findasifrahman/mt76--/mt7628v1.kicad_pcb

## KiCad design mt7628v1.kicad_pcb (2025-05-23)

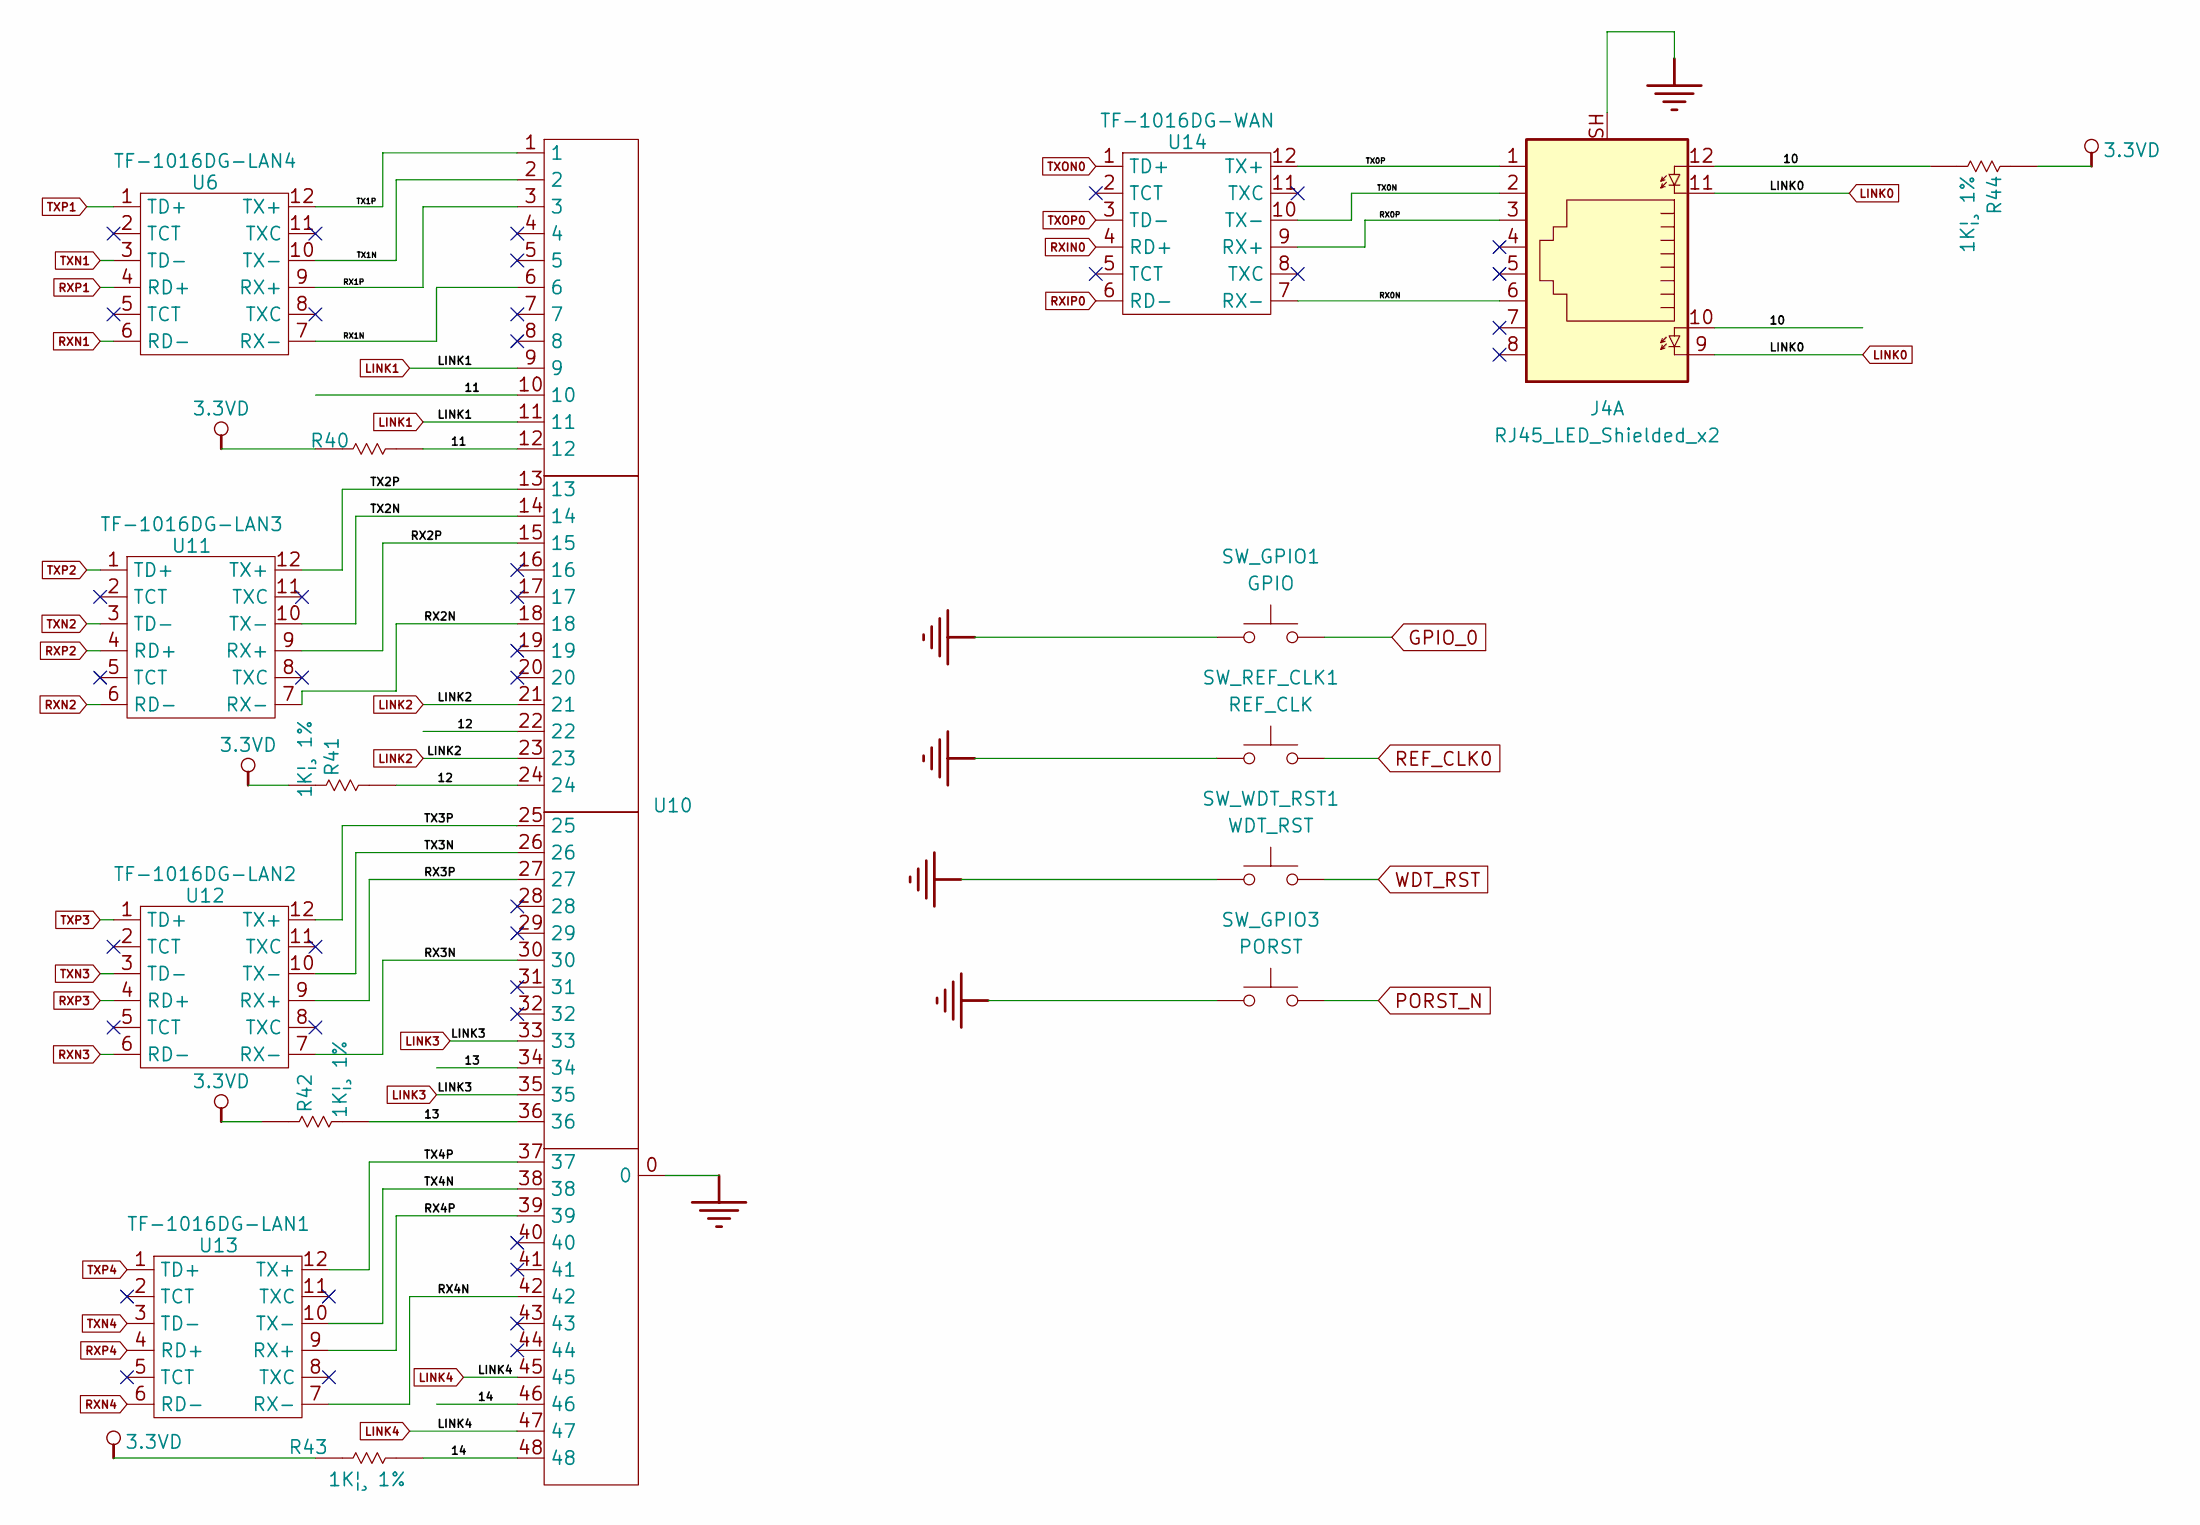
[picture p1: schematic ethernet.kicad_sch]

Parts:
J4: RJ45_LED_Shielded_x2; RJ45-TH_DS1128-09-S8B8X; LCSC C86578
R40, R41, R42, R43, R44: 1k/1%; R_0402_1005Metric; LCSC C11702
SW_GPIO1: GPIO; SW-SMD_L3.9-W2.9-LS4.8-EH-A; LCSC C9900006416
SW_GPIO3: PORST; SW-SMD_L3.9-W2.9-LS4.8-EH-A; LCSC C9900006416
SW_REF_CLK1: REF_CLK; SW-SMD_L3.9-W2.9-LS4.8-EH-A; LCSC C9900006416
SW_WDT_RST1: WDT_RST; SW-SMD_L3.9-W2.9-LS4.8-EH-A; LCSC C9900006416
U6: TF-1016DG-LAN4; DIP-12_L12.8-W7.3-P2.00-LS5.0-BL; LCSC C408871
U10: RJ45-TH_B-1-4; LCSC C138390
U11: TF-1016DG-LAN3; DIP-12_L12.8-W7.3-P2.00-LS5.0-BL; LCSC C408871
U12: TF-1016DG-LAN2; DIP-12_L12.8-W7.3-P2.00-LS5.0-BL; LCSC C408871
U13: TF-1016DG-LAN1; DIP-12_L12.8-W7.3-P2.00-LS5.0-BL; LCSC C408871
U14: TF-1016DG-WAN; DIP-12_L12.8-W7.3-P2.00-LS5.0-BL; LCSC C408871

Connections:
3.3VD: R40.2, R41.2, R42.2, R43.2, R44.2; also elsewhere on the board
/ethernet/10: J4.10, J4.12, R44.1
/ethernet/11: R40.1, U10.10, U10.12
/ethernet/12: R41.1, U10.22, U10.24
/ethernet/13: R42.1, U10.34, U10.36
/ethernet/14: R43.1, U10.46, U10.48
/ethernet/RX0N: J4.6, U14.7 (RX-)
/ethernet/RX0P: J4.3, U14.9 (RX+)
/ethernet/RX1N: U6.7 (RX-), U10.6
/ethernet/RX1P: U6.9 (RX+), U10.3
/ethernet/RX2N: U10.18, U11.7 (RX-)
/ethernet/RX2P: U10.15, U11.9 (RX+)
/ethernet/RX3N: U10.30, U12.7 (RX-)
/ethernet/RX3P: U10.27, U12.9 (RX+)
/ethernet/RX4N: U10.42, U13.7 (RX-)
/ethernet/RX4P: U10.39, U13.9 (RX+)
/ethernet/TX0N: J4.2, U14.10 (TX-)
/ethernet/TX0P: J4.1, U14.12 (TX+)
/ethernet/TX1N: U6.10 (TX-), U10.2
/ethernet/TX1P: U6.12 (TX+), U10.1
/ethernet/TX2N: U10.14, U11.10 (TX-)
/ethernet/TX2P: U10.13, U11.12 (TX+)
/ethernet/TX3N: U10.26, U12.10 (TX-)
/ethernet/TX3P: U10.25, U12.12 (TX+)
/ethernet/TX4N: U10.38, U13.10 (TX-)
/ethernet/TX4P: U10.37, U13.12 (TX+)
CPURST_N: SW_GPIO3.2; also elsewhere on the board
GND: J4.SH, SW_GPIO1.1, SW_GPIO3.1, SW_REF_CLK1.1, SW_WDT_RST1.1, U10.0; also elsewhere on the board
GPIO_0: SW_GPIO1.2; also elsewhere on the board
LINK0: J4.9, J4.11; also elsewhere on the board
LINK1: U10.9, U10.11; also elsewhere on the board
LINK2: U10.21, U10.23; also elsewhere on the board
LINK3: U10.33, U10.35; also elsewhere on the board
LINK4: U10.45, U10.47; also elsewhere on the board
REF_CLK0: SW_REF_CLK1.2; also elsewhere on the board
RXIN0: U14.4 (RD+); also elsewhere on the board
RXIP0: U14.6 (RD-); also elsewhere on the board
RXN1: U6.6 (RD-); also elsewhere on the board
RXN2: U11.6 (RD-); also elsewhere on the board
RXN3: U12.6 (RD-); also elsewhere on the board
RXN4: U13.6 (RD-); also elsewhere on the board
RXP1: U6.4 (RD+); also elsewhere on the board
RXP2: U11.4 (RD+); also elsewhere on the board
RXP3: U12.4 (RD+); also elsewhere on the board
RXP4: U13.4 (RD+); also elsewhere on the board
TXN1: U6.3 (TD-); also elsewhere on the board
TXN2: U11.3 (TD-); also elsewhere on the board
TXN3: U12.3 (TD-); also elsewhere on the board
TXN4: U13.3 (TD-); also elsewhere on the board
TXON0: U14.1 (TD+); also elsewhere on the board
TXOP0: U14.3 (TD-); also elsewhere on the board
TXP1: U6.1 (TD+); also elsewhere on the board
TXP2: U11.1 (TD+); also elsewhere on the board
TXP3: U12.1 (TD+); also elsewhere on the board
TXP4: U13.1 (TD+); also elsewhere on the board
WDT_RST: SW_WDT_RST1.2; also elsewhere on the board

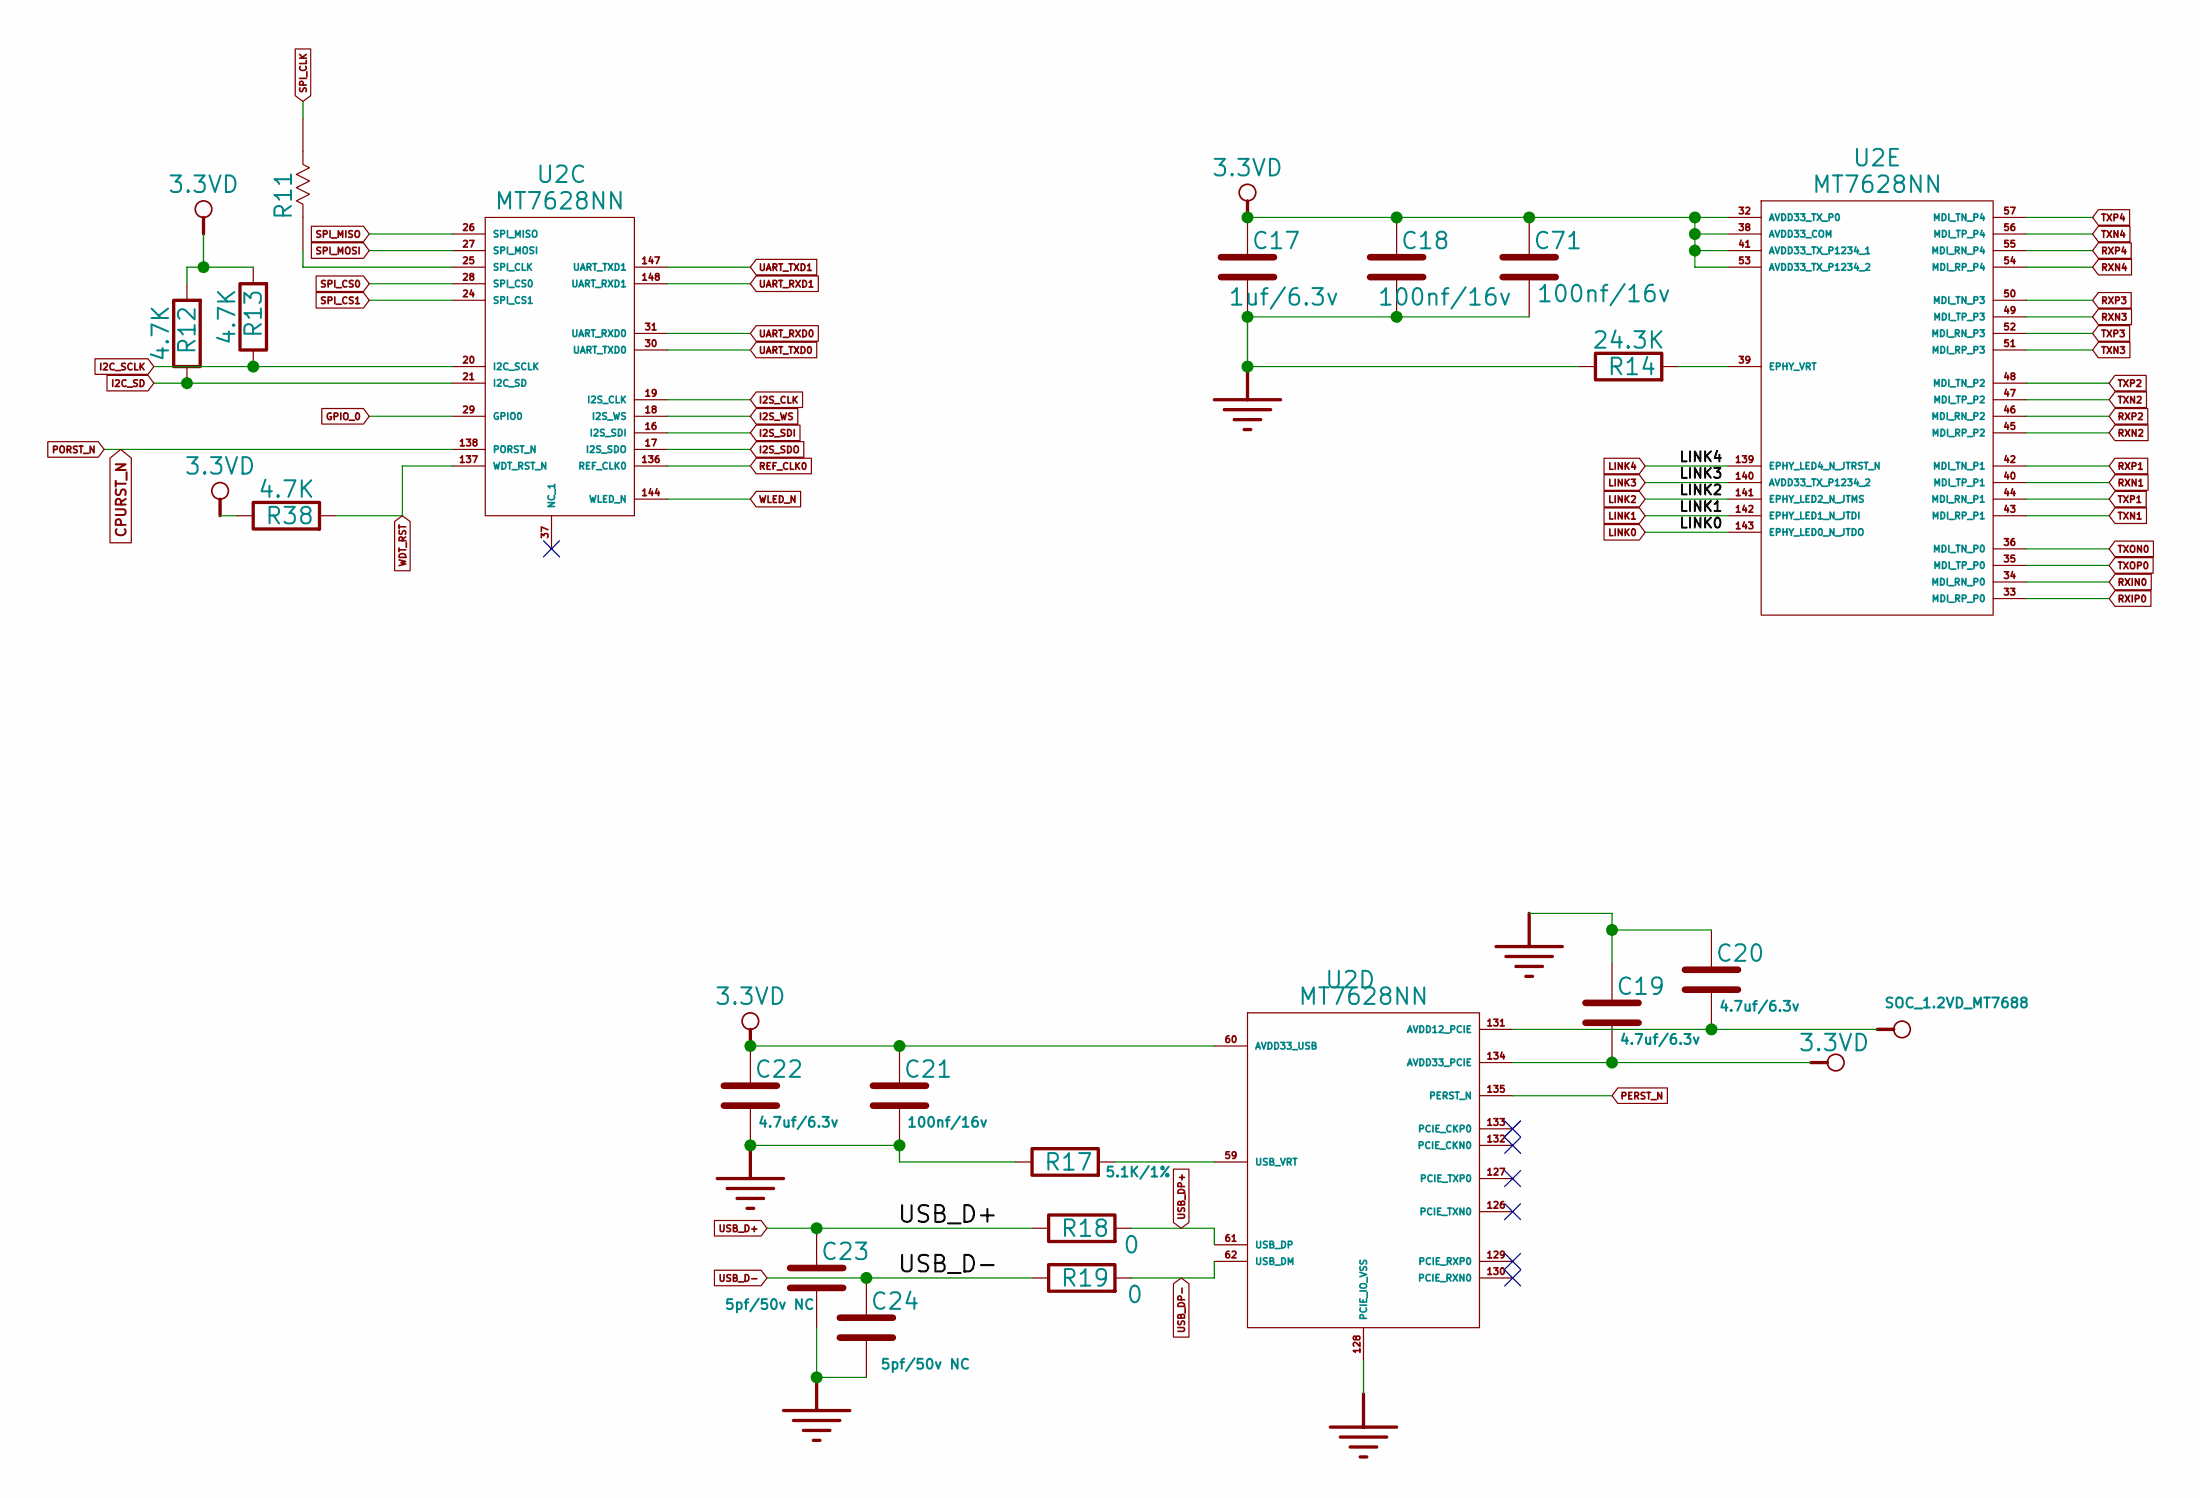
[picture p2: schematic Pheripheral.kicad_sch]

Parts:
C17: 1uf/6.3v; C_0402_1005Metric; LCSC C15684
C18, C21, C71: 100nf/16v; C_0402_1005Metric; LCSC C1525
C19, C20, C22: 4.7uf/6.3v; C_0603_1608Metric; LCSC C8032
C23, C24: 5pf/50v NC; C_0402_1005Metric; LCSC C1573
R11: 22; R_0402_1005Metric; LCSC C25092
R12, R13, R38: 4.7K; R_0402_1005Metric; LCSC C25900
R14: 24.3K; R_0402_1005Metric; LCSC C102920
R17: 5.1K/1%; C_0402_1005Metric; LCSC C25905
R18, R19: 0; R_0402_1005Metric; LCSC C17168
U2: MT7628NN; MT7628_footprint; LCSC C2762437

Connections:
3.3VD: C17.1, C18.1, C19.2, C21.1, C22.1, C71.1, R12.2, R13.2, R38.1, U2.32 (AVDD33_TX_P0), U2.38 (AVDD33_COM), U2.41 (AVDD33_TX_P1234_1), U2.53 (AVDD33_TX_P1234_2), U2.60 (AVDD33_USB), U2.134 (AVDD33_PCIE); also elsewhere on the board
CPURST_N: U2.138 (PORST_N); also elsewhere on the board
GND: C17.2, C18.2, C19.1, C20.1, C21.2, C22.2, C23.2, C24.2, C71.2, R14.1, R17.1, U2.128 (PCIE_IO_VSS); also elsewhere on the board
GPIO_0: U2.29 (GPIO0); also elsewhere on the board
I2C_SCLK: R13.1, U2.20 (I2C_SCLK); also elsewhere on the board
I2C_SD: R12.1, U2.21 (I2C_SD); also elsewhere on the board
I2S_CLK: U2.19 (I2S_CLK); also elsewhere on the board
I2S_SDI: U2.16 (I2S_SDI); also elsewhere on the board
I2S_SDO: U2.17 (I2S_SDO); also elsewhere on the board
I2S_WS: U2.18 (I2S_WS); also elsewhere on the board
LINK0: U2.143 (EPHY_LED0_N_JTDO); also elsewhere on the board
LINK1: U2.142 (EPHY_LED1_N_JTDI); also elsewhere on the board
LINK2: U2.141 (EPHY_LED2_N_JTMS); also elsewhere on the board
LINK3: U2.140 (AVDD33_TX_P1234_2); also elsewhere on the board
LINK4: U2.139 (EPHY_LED4_N_JTRST_N); also elsewhere on the board
unnamed: R11.2, U2.25 (SPI_CLK)
unnamed: R17.2, U2.59 (USB_VRT)
unnamed: R14.2, U2.39 (EPHY_VRT)
PERST_N: U2.135 (PERST_N); also elsewhere on the board
REF_CLK0: U2.136 (REF_CLK0); also elsewhere on the board
RXIN0: U2.34 (MDI_RN_P0); also elsewhere on the board
RXIP0: U2.33 (MDI_RP_P0); also elsewhere on the board
RXN1: U2.40 (MDI_TP_P1); also elsewhere on the board
RXN2: U2.45 (MDI_RP_P2); also elsewhere on the board
RXN3: U2.49 (MDI_TP_P3); also elsewhere on the board
RXN4: U2.54 (MDI_RP_P4); also elsewhere on the board
RXP1: U2.42 (MDI_TN_P1); also elsewhere on the board
RXP2: U2.46 (MDI_RN_P2); also elsewhere on the board
RXP3: U2.50 (MDI_TN_P3); also elsewhere on the board
RXP4: U2.55 (MDI_RN_P4); also elsewhere on the board
SOC_1.2VD_MT7688: C20.2, U2.131 (AVDD12_PCIE)
SPI_CLK: R11.1; also elsewhere on the board
SPI_CS0: U2.28 (SPI_CS0); also elsewhere on the board
SPI_CS1: U2.24 (SPI_CS1); also elsewhere on the board
SPI_MISO: U2.26 (SPI_MISO); also elsewhere on the board
SPI_MOSI: U2.27 (SPI_MOSI); also elsewhere on the board
TXN1: U2.43 (MDI_RP_P1); also elsewhere on the board
TXN2: U2.47 (MDI_TP_P2); also elsewhere on the board
TXN3: U2.51 (MDI_RP_P3); also elsewhere on the board
TXN4: U2.56 (MDI_TP_P4); also elsewhere on the board
TXON0: U2.36 (MDI_TN_P0); also elsewhere on the board
TXOP0: U2.35 (MDI_TP_P0); also elsewhere on the board
TXP1: U2.44 (MDI_RN_P1); also elsewhere on the board
TXP2: U2.48 (MDI_TN_P2); also elsewhere on the board
TXP3: U2.52 (MDI_RN_P3); also elsewhere on the board
TXP4: U2.57 (MDI_TN_P4); also elsewhere on the board
UART_RXD0: U2.31 (UART_RXD0); also elsewhere on the board
UART_RXD1: U2.148 (UART_RXD1); also elsewhere on the board
UART_TXD0: U2.30 (UART_TXD0); also elsewhere on the board
UART_TXD1: U2.147 (UART_TXD1); also elsewhere on the board
USB_D+: C23.1, R18.1; also elsewhere on the board
USB_D-: C24.1, R19.1; also elsewhere on the board
USB_DP+: R18.2, U2.61 (USB_DP)
USB_DP-: R19.2, U2.62 (USB_DM)
WDT_RST: R38.2, U2.137 (WDT_RST_N); also elsewhere on the board
WLED_N: U2.144 (WLED_N); also elsewhere on the board

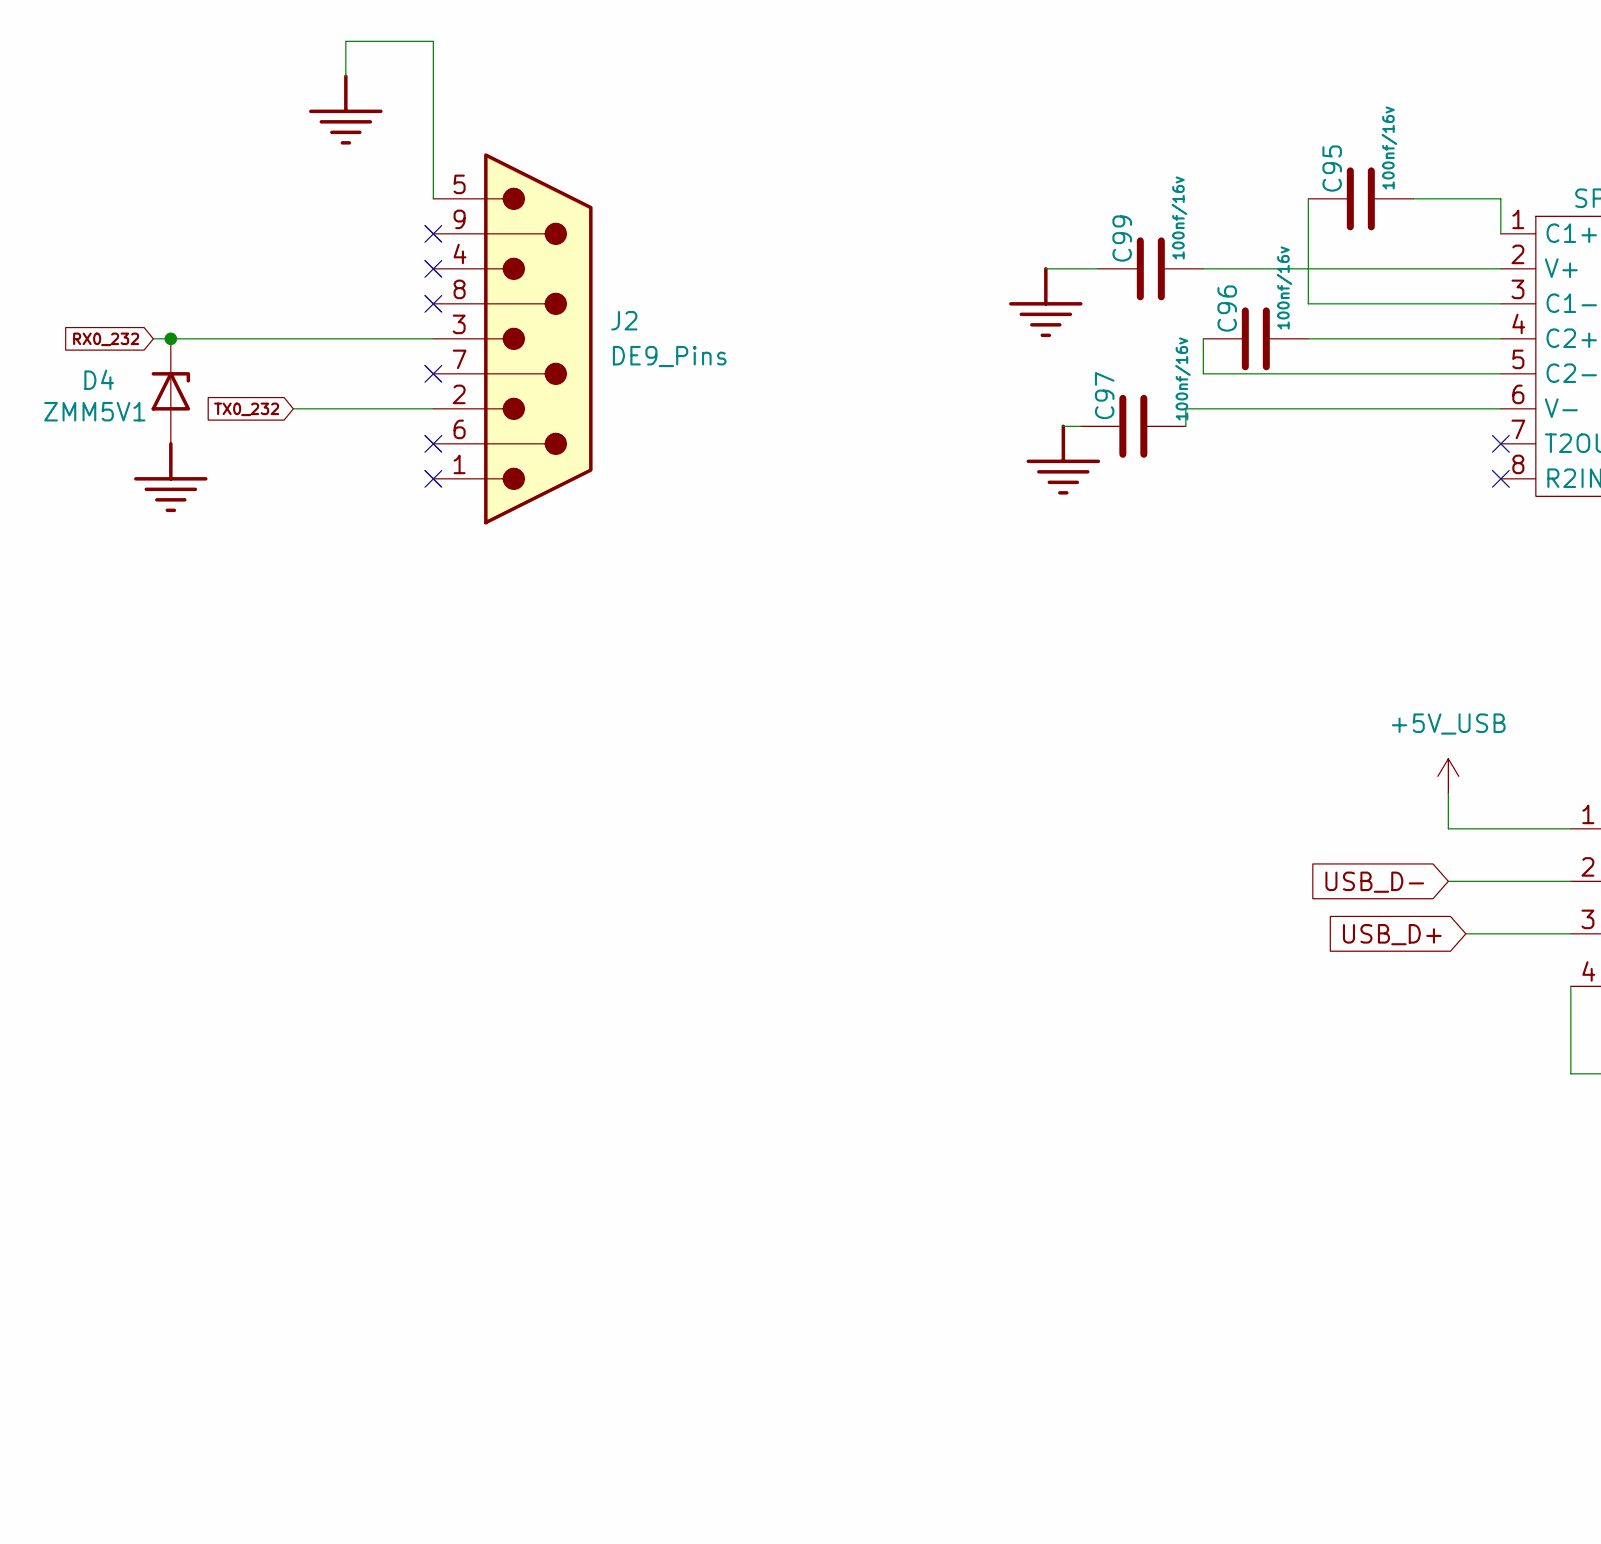
[picture p3: schematic serial.kicad_sch, part in row 1, column 1]

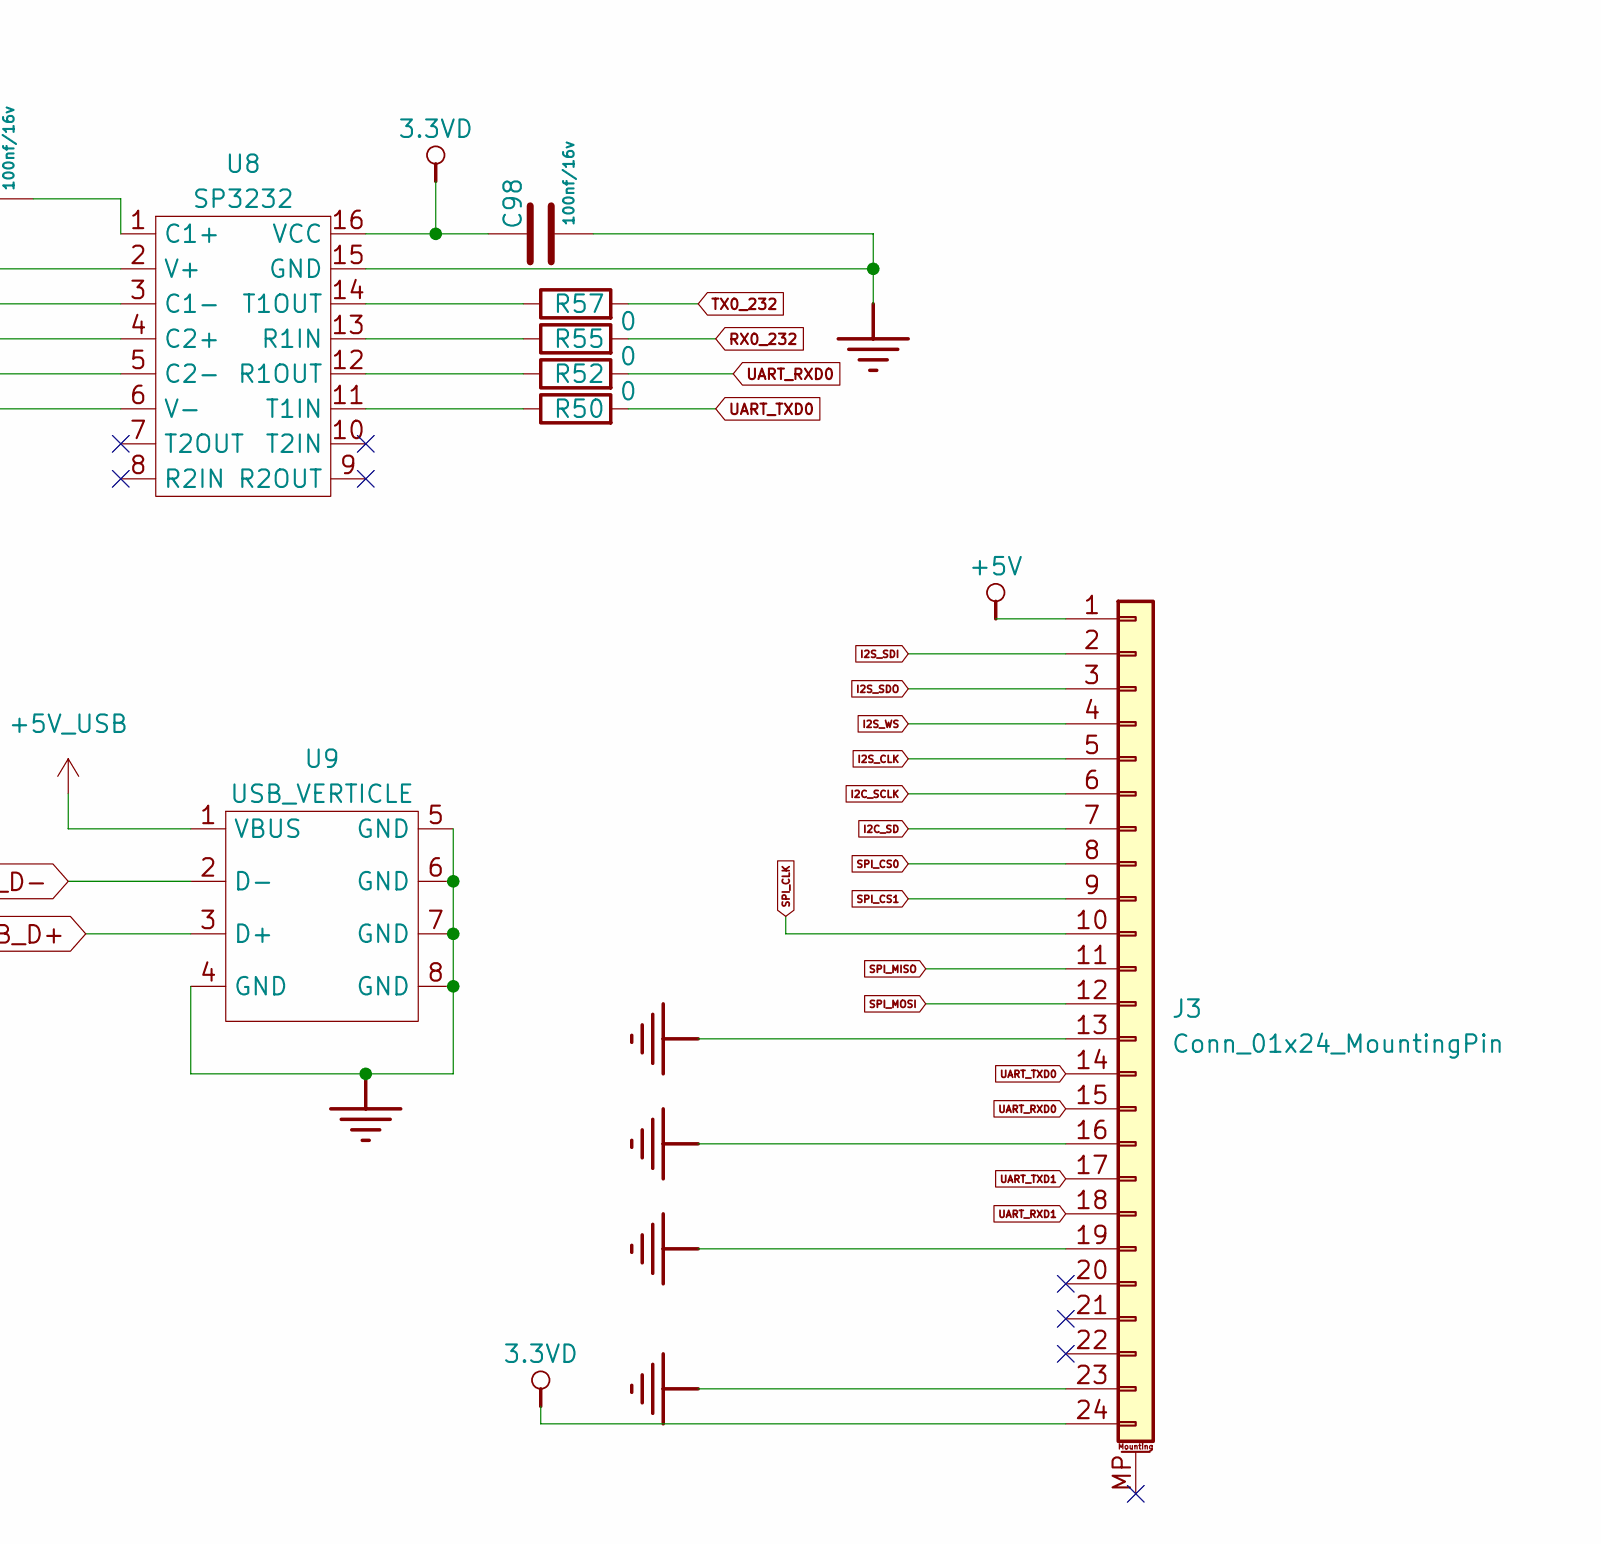
[picture p4: schematic serial.kicad_sch, part in row 1, column 2]

Parts:
C95, C96, C97, C98, C99: 100nf/16v; C_0402_1005Metric; LCSC C1525
D4: ZMM5V1; LL-34_L3.5-W1.5-RD; LCSC C707194
J2: DE9_Pins; HDR-TH_HL-DP9HB180F; LCSC C9900001049
J3: Conn_01x24_MountingPin; HDR-TH_24P-P2.54-V-M-R2-C12-S2.54; LCSC C358700
R50, R52, R55, R57: 0; R_0402_1005Metric; LCSC C17168
U8: SP3232; SOIC-16_L9.9-W3.9-P1.27-LS6.0-BL; LCSC C9378
U9: USB_VERTICLE; USB-A-TH_USB-226-BRW; LCSC C720524

Connections:
3.3VD: C98.1, J3.24, U8.16 (VCC); also elsewhere on the board
+5V: J3.1; also elsewhere on the board
+5V_USB: U9.1 (VBUS)
GND: C97.1, C98.2, C99.1, D4.2 (A), J2.5, J3.13, J3.16, J3.19, J3.23, U8.15 (GND), U9.4 (GND), U9.5 (GND), U9.6 (GND), U9.7 (GND), U9.8 (GND); also elsewhere on the board
I2C_SCLK: J3.6; also elsewhere on the board
I2C_SD: J3.7; also elsewhere on the board
I2S_CLK: J3.5; also elsewhere on the board
I2S_SDI: J3.2; also elsewhere on the board
I2S_SDO: J3.3; also elsewhere on the board
I2S_WS: J3.4; also elsewhere on the board
unnamed: C95.2, U8.1 (C1+)
unnamed: C95.1, U8.3 (C1-)
unnamed: C96.2, U8.4 (C2+)
unnamed: C96.1, U8.5 (C2-)
unnamed: R55.1, U8.13 (R1IN)
unnamed: R52.1, U8.12 (R1OUT)
unnamed: R50.1, U8.11 (T1IN)
unnamed: R57.1, U8.14 (T1OUT)
unnamed: C99.2, U8.2 (V+)
unnamed: C97.2, U8.6 (V-)
RX0_232: D4.1 (K), J2.3, R55.2
SPI_CLK: J3.10; also elsewhere on the board
SPI_CS0: J3.8; also elsewhere on the board
SPI_CS1: J3.9; also elsewhere on the board
SPI_MISO: J3.11; also elsewhere on the board
SPI_MOSI: J3.12; also elsewhere on the board
TX0_232: J2.2, R57.2
UART_RXD0: J3.15, R52.2; also elsewhere on the board
UART_RXD1: J3.18; also elsewhere on the board
UART_TXD0: J3.14, R50.2; also elsewhere on the board
UART_TXD1: J3.17; also elsewhere on the board
USB_D+: U9.3 (D+); also elsewhere on the board
USB_D-: U9.2 (D-); also elsewhere on the board

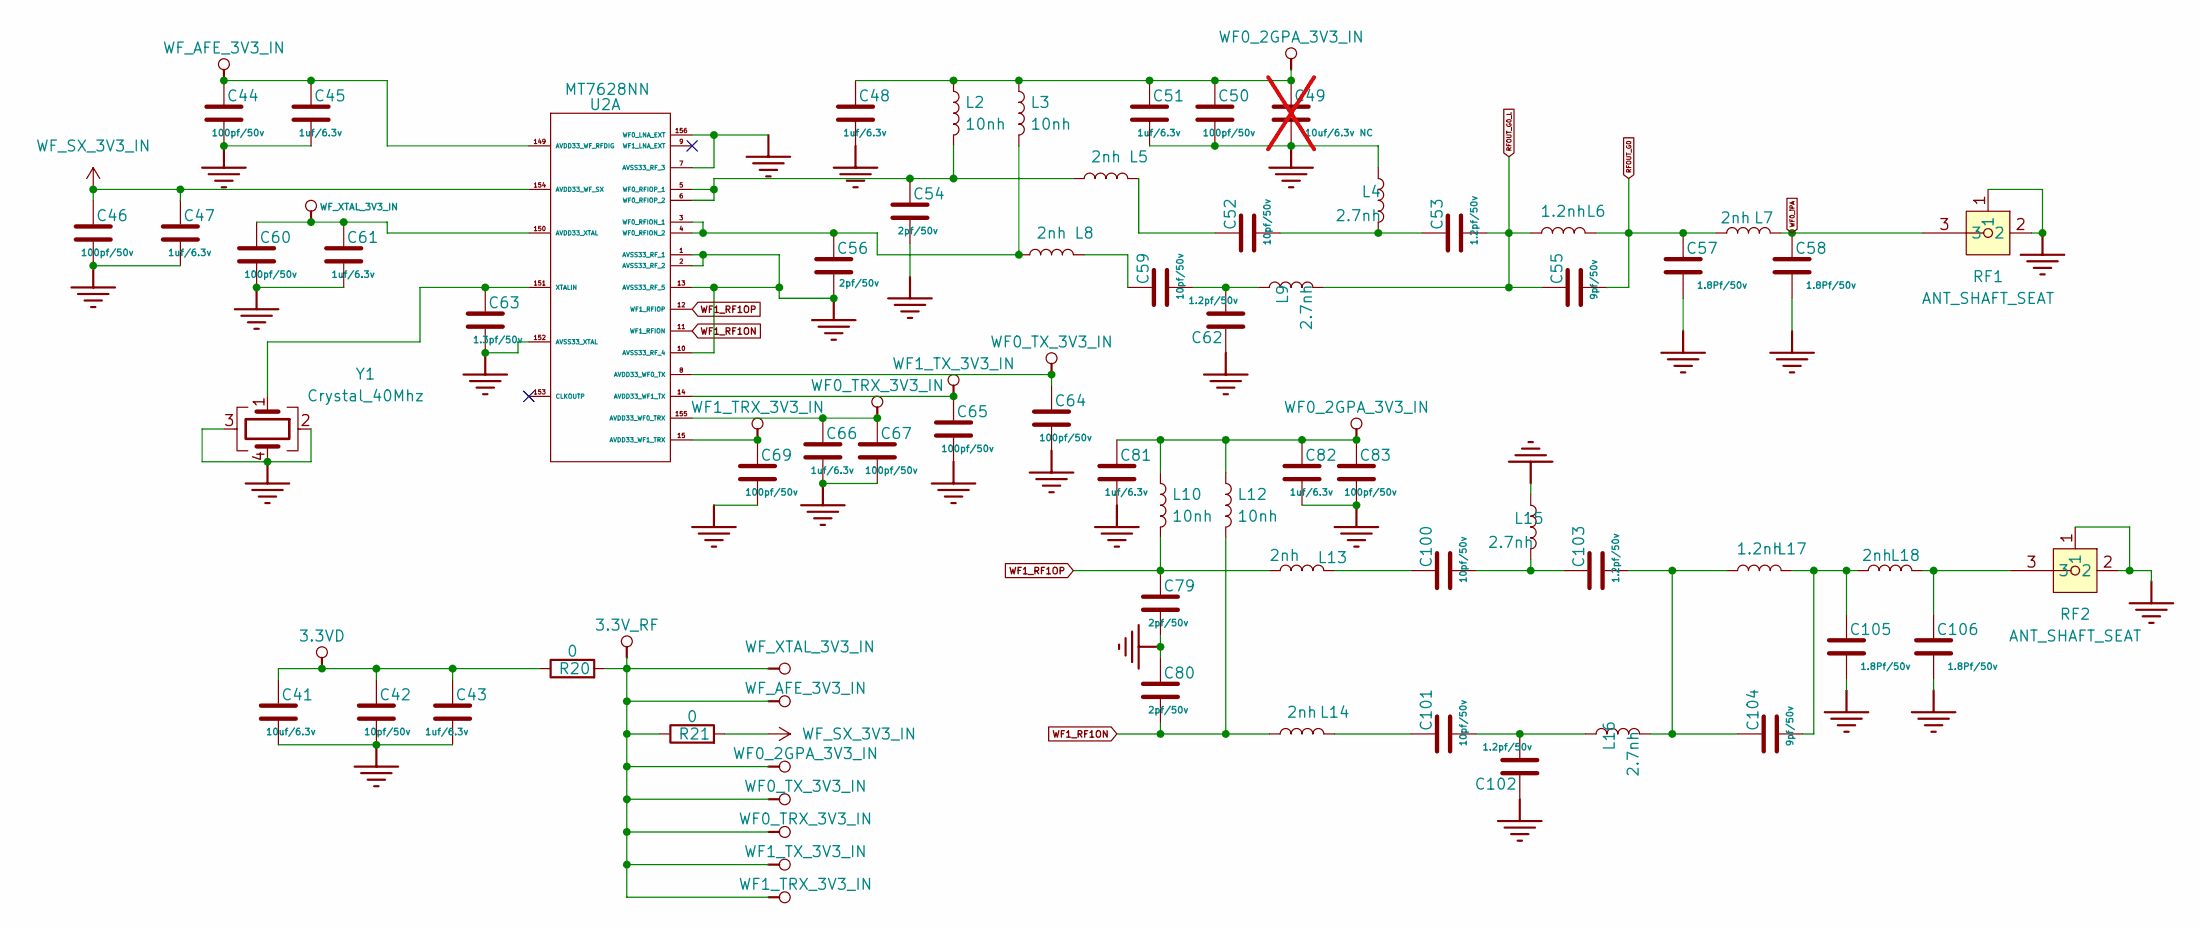
[picture p5: schematic RF_Front_End.kicad_sch]

Parts:
C41: 10uf/6.3v; C_0603_1608Metric; LCSC C1691
C42, C52, C59, C100, C101: 10pf/50v; C_0402_1005Metric; LCSC C32949
C43, C45, C47, C48, C51, C61, C66, C81, C82: 1uf/6.3v; C_0402_1005Metric; LCSC C15684
C44, C46, C50, C60, C64, C65, C67, C69, C83: 100pf/50v; C_0402_1005Metric; LCSC C1546
C49: 10uf/6.3v NC; C_0603_1608Metric; LCSC C1691; not fitted
C53, C62, C102, C103: 1.2pf/50v; C_0402_1005Metric; LCSC C1551
C54, C56, C79, C80: 2pf/50v; C_0402_1005Metric; LCSC C1523
C55, C104: 9pf/50v; C_0402_1005Metric; LCSC C1580
C57, C58, C105, C106: 1.8Pf/50v; C_0402_1005Metric; LCSC C1553
C63: 1.3pf/50v; C_0402_1005Metric; LCSC C88880
L2, L3, L10, L12: 10nh; L_0402_1005Metric; LCSC C21585
L4, L9, L15, L16: 2.7nh; L_0402_1005Metric; LCSC C76770
L5, L7, L8, L13, L14, L18: 2nh; L_0402_1005Metric; LCSC C18216
L6, L17: 1.2nh; L_0402_1005Metric; LCSC C77105
R20, R21: 0; R_0402_1005Metric; LCSC C17168
RF1, RF2: ANT_SHAFT_SEAT; IPEX-SMD_4P-L2.6-W2.6_C9900016457; LCSC C9900016457
U2: MT7628NN; MT7628_footprint; LCSC C2762437
Y1: Crystal_40Mhz; CRYSTAL-SMD_4P-L3.2-W2.5-BL; MFR.Part # 7M40000005; LCSC C90924

Connections:
3.3VD: C41.1, C42.1, C43.1, R20.1; also elsewhere on the board
3.3V_RF: C44.1, C45.1, C48.1, C49.1, C50.1, C51.1, C60.1, C61.1, C64.1, C65.1, C66.1, C67.1, C69.1, C81.1, C82.1, C83.1, L2.1, L3.1, L10.1, L12.1, R20.2, R21.1, U2.8 (AVDD33_WF0_TX), U2.14 (AVDD33_WF1_TX), U2.15 (AVDD33_WF1_TRX), U2.149 (AVDD33_WF_RFDIG), U2.150 (AVDD33_XTAL), U2.155 (AVDD33_WF0_TRX)
GND: C41.2, C42.2, C43.2, C44.2, C45.2, C46.2, C47.2, C48.2, C49.2, C50.2, C51.2, C54.2, C56.2, C57.2, C58.2, C60.2, C61.2, C62.1, C63.2, C64.2, C65.2, C66.2, C67.2, C69.2, C79.2, C80.1, C81.2, C82.2, C83.2, C102.1, C105.2, C106.2, L4.1, L15.1, RF1.1, RF1.2, RF2.1, RF2.2, U2.1 (AVSS33_RF_1), U2.2 (AVSS33_RF_2), U2.7 (AVSS33_RF_3), U2.10 (AVSS33_RF_4), U2.13 (AVSS33_RF_5), U2.152 (AVSS33_XTAL), U2.156 (WF0_LNA_EXT), Y1.2, Y1.3, Y1.4; also elsewhere on the board
unnamed: C52.1, L5.2
unnamed: C52.2, C53.1, L4.2
unnamed: C59.1, L8.2
unnamed: C59.2, C62.2, L9.1
unnamed: C100.1, L13.2
unnamed: C100.2, C103.1, L15.2
unnamed: C101.1, L14.2
unnamed: C101.2, C102.2, L16.1
unnamed: C103.2, C104.1, L16.2, L17.1
unnamed: C104.2, C105.1, L17.2, L18.1
unnamed: C106.1, L18.2, RF2.3
unnamed: C56.1, L3.2, L8.1, U2.3 (WF0_RFION_1), U2.4 (WF0_RFION_2)
unnamed: C54.1, L2.2, L5.1, U2.5 (WF0_RFIOP_1), U2.6 (WF0_RFIOP_2)
unnamed: C63.1, U2.151 (XTALIN), Y1.1
RFOUT_G0: C55.2, C57.1, L6.2, L7.1
RFOUT_G0_L: C53.2, C55.1, L6.1, L9.2
WF0_iPA: C58.1, L7.2, RF1.3
WF1_RF1ON: C80.2, L12.2, L14.1, U2.11 (WF1_RFION)
WF1_RF1OP: C79.1, L10.2, L13.1, U2.12 (WF1_RFIOP)
WF_SX_3V3_IN: C46.1, C47.1, R21.2, U2.154 (AVDD33_WF_SX)

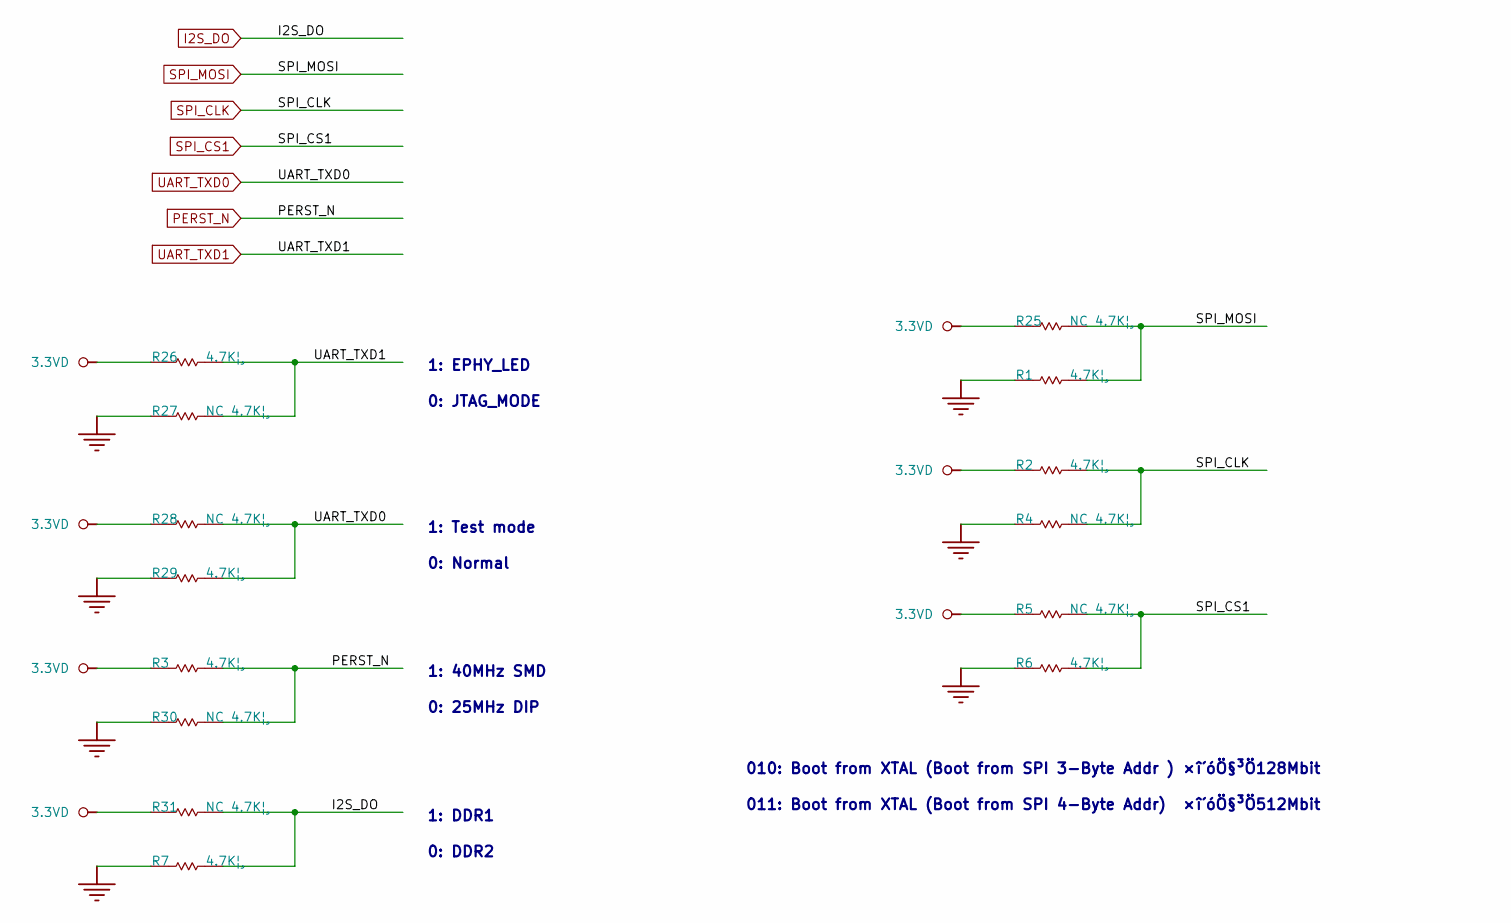
[picture p6: schematic config.kicad_sch]

Parts:
R1, R2, R3, R6, R7, R26, R29: 4.7k; R_0402_1005Metric; LCSC C25900
R4, R5, R25, R27, R28, R30, R31: 4.7k; R_0402_1005Metric; LCSC NC

Connections:
3.3VD: R2.1, R3.1, R5.1, R25.1, R26.1, R28.1, R31.1; also elsewhere on the board
GND: R1.1, R4.1, R6.1, R7.1, R27.1, R29.1, R30.1; also elsewhere on the board
I2S_DO: R7.2, R31.2
PERST_N: R3.2, R30.2; also elsewhere on the board
SPI_CLK: R2.2, R4.2; also elsewhere on the board
SPI_CS1: R5.2, R6.2; also elsewhere on the board
SPI_MOSI: R1.2, R25.2; also elsewhere on the board
UART_TXD0: R28.2, R29.2; also elsewhere on the board
UART_TXD1: R26.2, R27.2; also elsewhere on the board

Notes on the sheet:
010: Boot from XTAL (Boot from SPI 3-Byte Addr ) ×î´óÖ§³Ö128Mbit
0: JTAG_MODE
0: 25MHz DIP
0: DDR2
1: Test mode
1: EPHY_LED
0: Normal
1: 40MHz SMD
1: DDR1
011: Boot from XTAL (Boot from SPI 4-Byte Addr) ×î´óÖ§³Ö512Mbit
