findasifrahman/mt76--/mt7628v1.kicad_pcb

## KiCad design mt7628v1.kicad_pcb (continued)

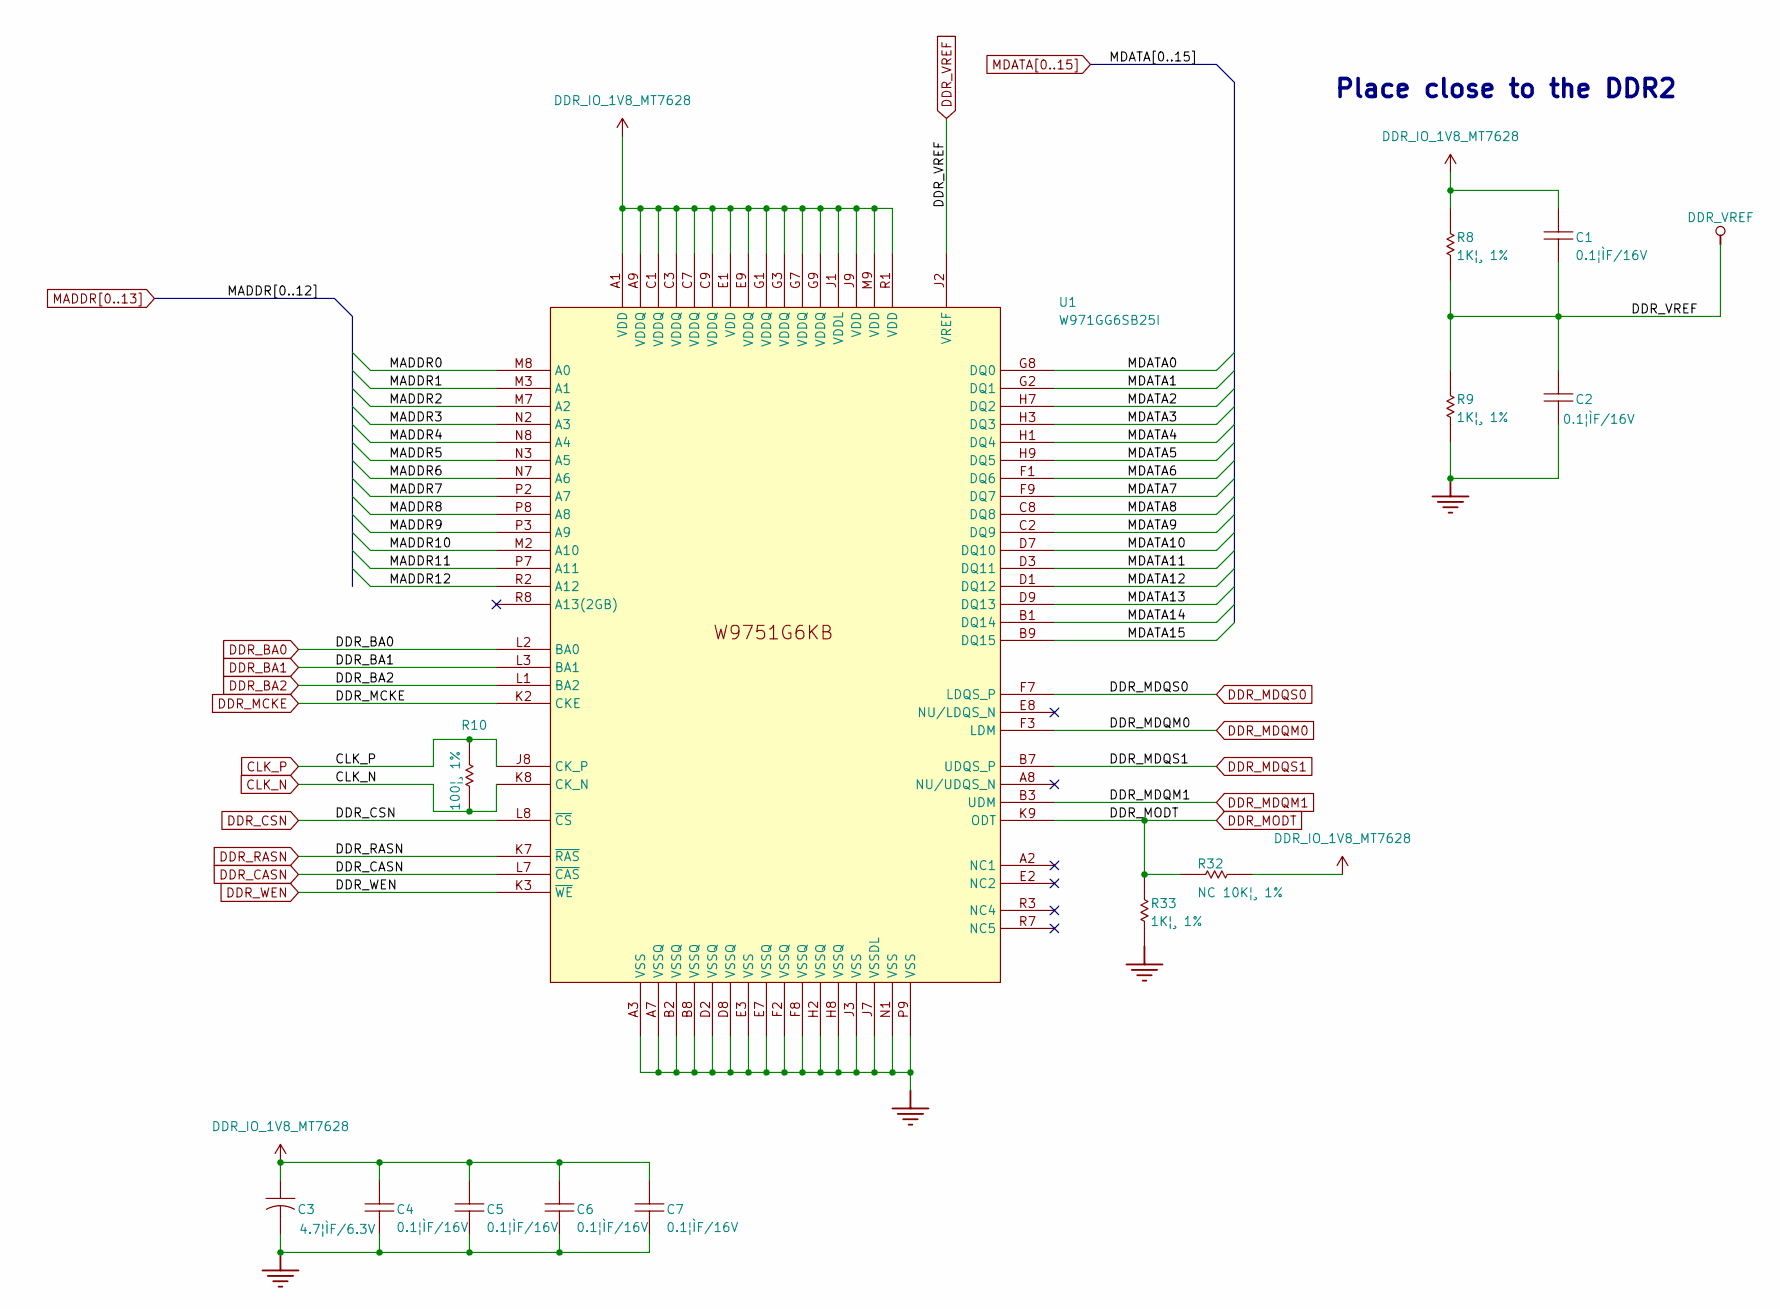
[picture p7: schematic ddr_cfg.kicad_sch]

Parts:
C1, C2, C4, C5, C6, C7: 100nf/16v; C_0402_1005Metric; LCSC C1525
C3: 4.7uf/6.3v; C_0603_1608Metric; LCSC C8032
R8: 1K/1%; R_0402_1005Metric; LCSC C11702
R9: 100nf/1%; R_0402_1005Metric; LCSC C11702
R10: 100/1%; R_0402_1005Metric; LCSC C25076
R32: 10k/1%; R_0402_1005Metric; LCSC C25744
R33: 1k/1%; R_0402_1005Metric; LCSC C11702
U1: W971GG6SB25I; WBGA-84_L12.5-W8.0-P0.80-TL_W9751G6KB; LCSC C191947

Connections:
CLK_N: R10.1, U1.K8 (CK_N); also elsewhere on the board
CLK_P: R10.2, U1.J8 (CK_P); also elsewhere on the board
DDR_BA0: U1.L2 (BA0); also elsewhere on the board
DDR_BA1: U1.L3 (BA1); also elsewhere on the board
DDR_BA2: U1.L1 (BA2); also elsewhere on the board
DDR_CASN: U1.L7 (~CAS); also elsewhere on the board
DDR_CSN: U1.L8 (~CS); also elsewhere on the board
DDR_IO_1V8_MT7628: C1.2, C3.1, C4.2, C5.2, C6.2, C7.2, R8.2, R32.1, U1.A1 (VDD), U1.A9 (VDDQ), U1.C1 (VDDQ), U1.C3 (VDDQ), U1.C7 (VDDQ), U1.C9 (VDDQ), U1.E1 (VDD), U1.E9 (VDDQ), U1.G1 (VDDQ), U1.G3 (VDDQ), U1.G7 (VDDQ), U1.G9 (VDDQ), U1.J1 (VDDL), U1.J9 (VDD), U1.M9 (VDD), U1.R1 (VDD); also elsewhere on the board
DDR_MCKE: U1.K2 (CKE); also elsewhere on the board
DDR_MDQM0: U1.F3 (LDM); also elsewhere on the board
DDR_MDQM1: U1.B3 (UDM); also elsewhere on the board
DDR_MDQS0: U1.F7 (LDQS_P); also elsewhere on the board
DDR_MDQS1: U1.B7 (UDQS_P); also elsewhere on the board
DDR_MODT: R32.2, R33.2, U1.K9 (ODT); also elsewhere on the board
DDR_RASN: U1.K7 (~RAS); also elsewhere on the board
DDR_VREF: C1.1, C2.2, R8.1, R9.2, U1.J2 (VREF); also elsewhere on the board
DDR_WEN: U1.K3 (~WE); also elsewhere on the board
GND: C2.1, C3.2, C4.1, C5.1, C6.1, C7.1, R9.1, R33.1, U1.A3 (VSS), U1.A7 (VSSQ), U1.B2 (VSSQ), U1.B8 (VSSQ), U1.D2 (VSSQ), U1.D8 (VSSQ), U1.E3 (VSS), U1.E7 (VSSQ), U1.F2 (VSSQ), U1.F8 (VSSQ), U1.H2 (VSSQ), U1.H8 (VSSQ), U1.J3 (VSS), U1.J7 (VSSDL), U1.N1 (VSS), U1.P9 (VSS); also elsewhere on the board
MADDR0: U1.M8 (A0); also elsewhere on the board
MADDR1: U1.M3 (A1); also elsewhere on the board
MADDR2: U1.M7 (A2); also elsewhere on the board
MADDR3: U1.N2 (A3); also elsewhere on the board
MADDR4: U1.N8 (A4); also elsewhere on the board
MADDR5: U1.N3 (A5); also elsewhere on the board
MADDR6: U1.N7 (A6); also elsewhere on the board
MADDR7: U1.P2 (A7); also elsewhere on the board
MADDR8: U1.P8 (A8); also elsewhere on the board
MADDR9: U1.P3 (A9); also elsewhere on the board
MADDR10: U1.M2 (A10); also elsewhere on the board
MADDR11: U1.P7 (A11); also elsewhere on the board
MADDR12: U1.R2 (A12); also elsewhere on the board
MDATA0: U1.G8 (DQ0); also elsewhere on the board
MDATA1: U1.G2 (DQ1); also elsewhere on the board
MDATA2: U1.H7 (DQ2); also elsewhere on the board
MDATA3: U1.H3 (DQ3); also elsewhere on the board
MDATA4: U1.H1 (DQ4); also elsewhere on the board
MDATA5: U1.H9 (DQ5); also elsewhere on the board
MDATA6: U1.F1 (DQ6); also elsewhere on the board
MDATA7: U1.F9 (DQ7); also elsewhere on the board
MDATA8: U1.C8 (DQ8); also elsewhere on the board
MDATA9: U1.C2 (DQ9); also elsewhere on the board
MDATA10: U1.D7 (DQ10); also elsewhere on the board
MDATA11: U1.D3 (DQ11); also elsewhere on the board
MDATA12: U1.D1 (DQ12); also elsewhere on the board
MDATA13: U1.D9 (DQ13); also elsewhere on the board
MDATA14: U1.B1 (DQ14); also elsewhere on the board
MDATA15: U1.B9 (DQ15); also elsewhere on the board

Notes on the sheet:
Place close to the DDR2

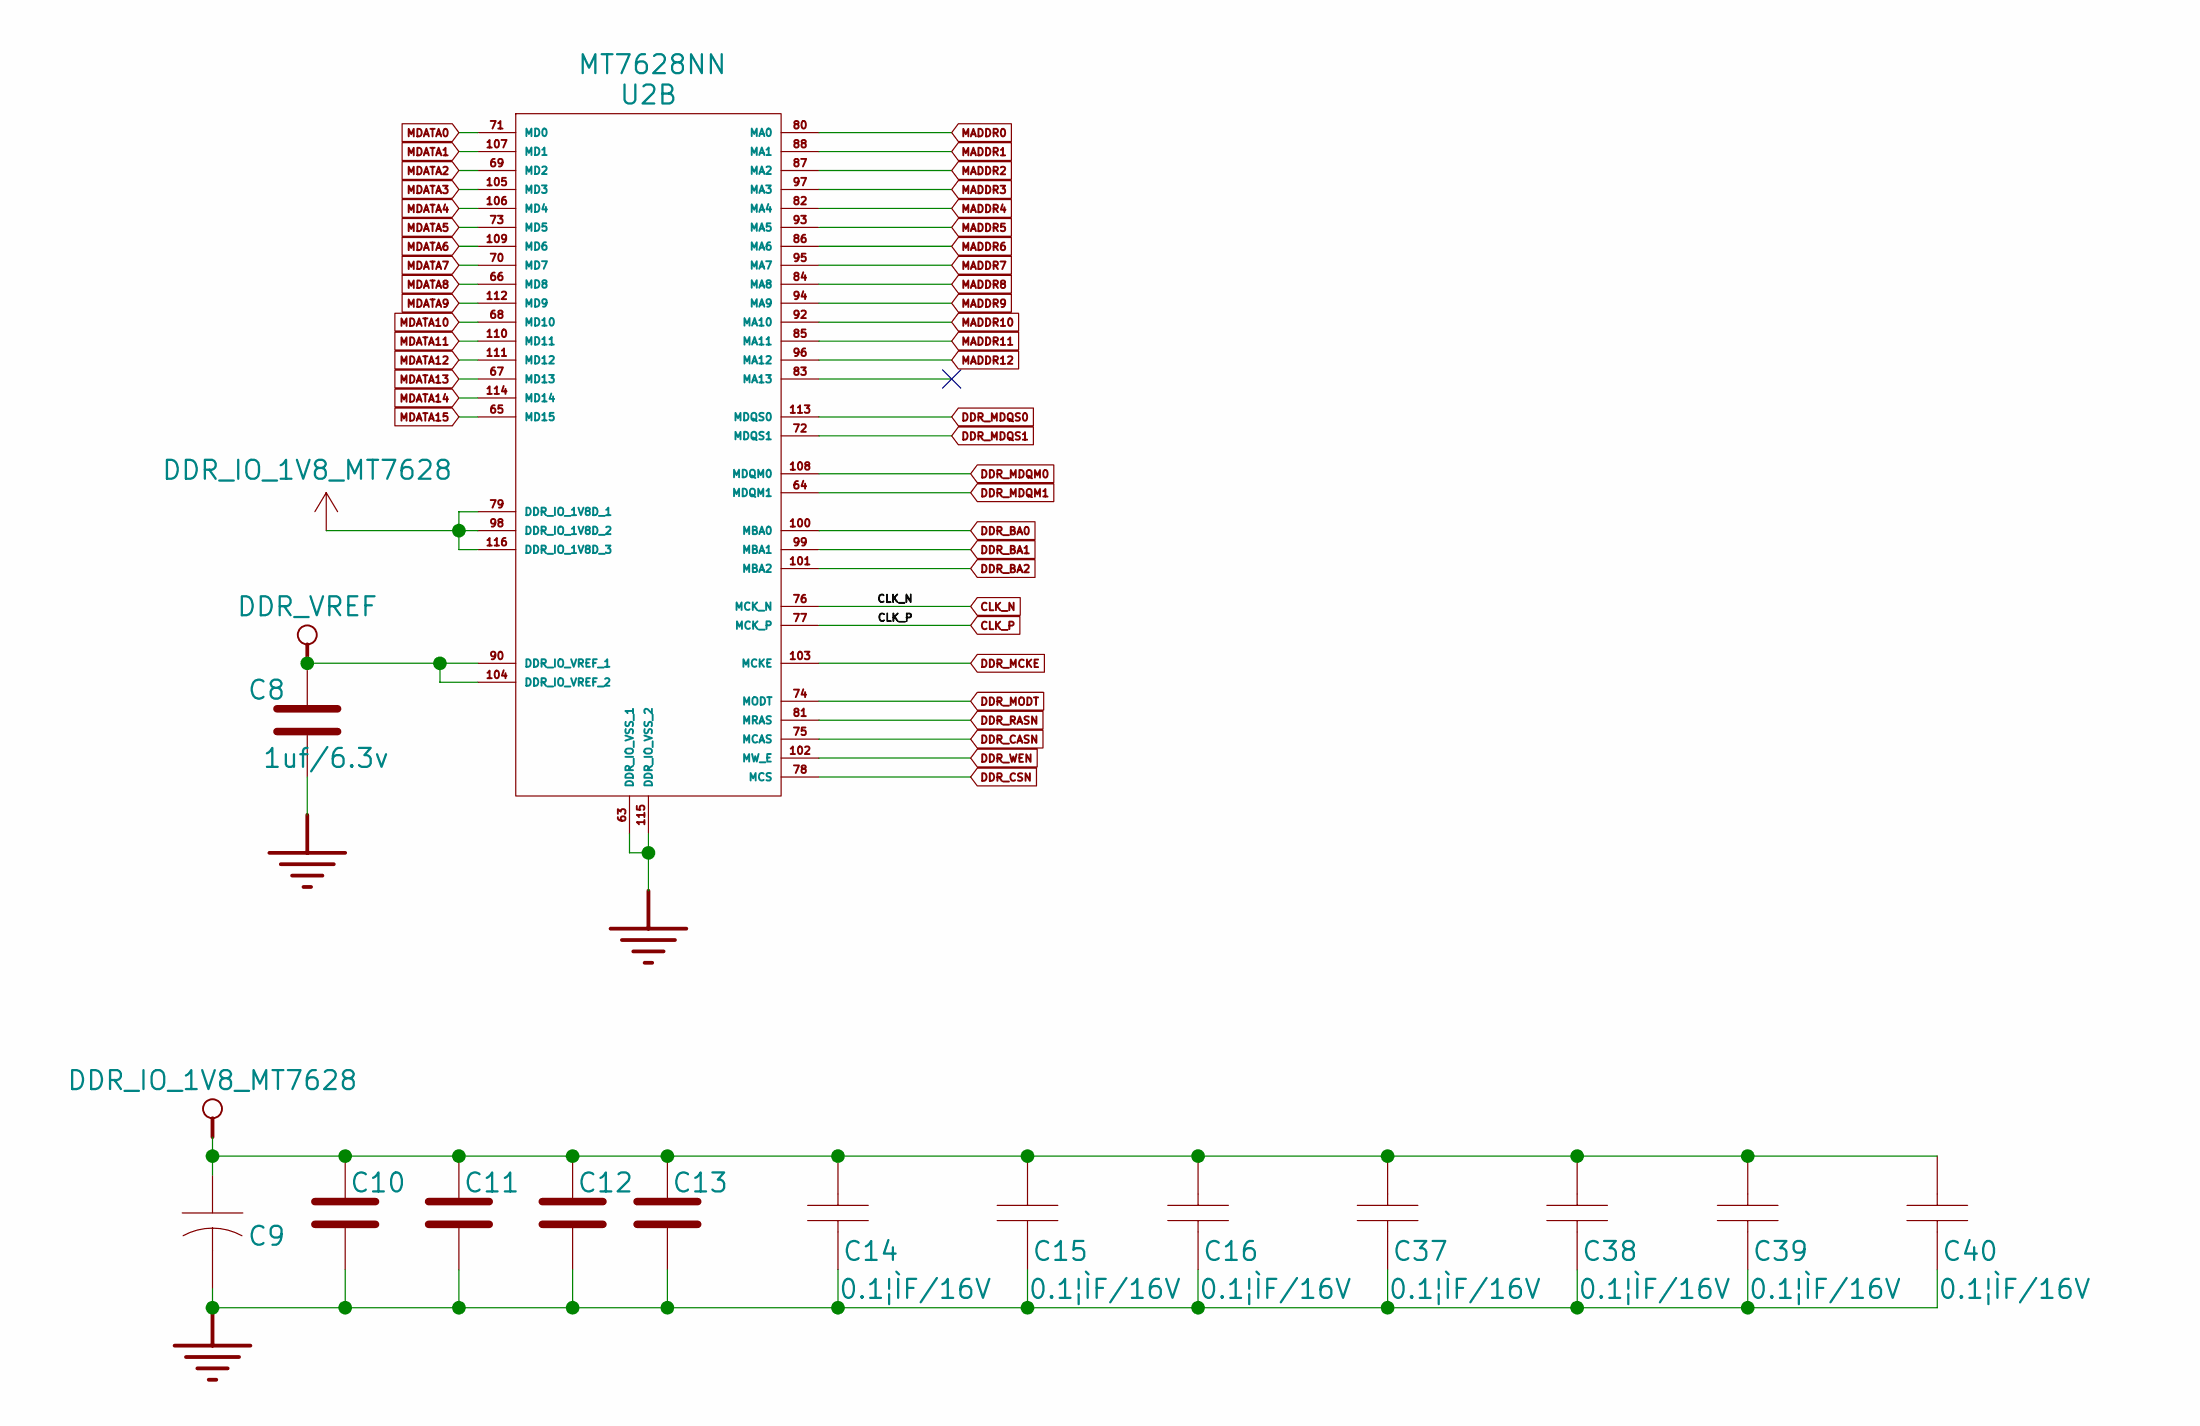
[picture p8: schematic ddr_if.kicad_sch]

Parts:
C8, C10, C11: 1uf/6.3v; C_0402_1005Metric; LCSC C15684
C9: 2.2uF/6.3V; C_0603_1608Metric; LCSC C71000
C12, C13: 1.5nf/50V; C_0402_1005Metric; LCSC C23967
C14, C15, C16, C37, C38, C39, C40: 100nf/16v; C_0402_1005Metric; LCSC C1525
U2: MT7628NN; MT7628_footprint; LCSC C2762437

Connections:
CLK_N: U2.76 (MCK_N); also elsewhere on the board
CLK_P: U2.77 (MCK_P); also elsewhere on the board
DDR_BA0: U2.100 (MBA0); also elsewhere on the board
DDR_BA1: U2.99 (MBA1); also elsewhere on the board
DDR_BA2: U2.101 (MBA2); also elsewhere on the board
DDR_CASN: U2.75 (MCAS); also elsewhere on the board
DDR_CSN: U2.78 (MCS); also elsewhere on the board
DDR_IO_1V8_MT7628: C9.1, C10.1, C11.1, C12.1, C13.1, C14.2, C15.2, C16.2, C37.2, C38.2, C39.2, C40.2, U2.79 (DDR_IO_1V8D_1), U2.98 (DDR_IO_1V8D_2), U2.116 (DDR_IO_1V8D_3); also elsewhere on the board
DDR_MCKE: U2.103 (MCKE); also elsewhere on the board
DDR_MDQM0: U2.108 (MDQM0); also elsewhere on the board
DDR_MDQM1: U2.64 (MDQM1); also elsewhere on the board
DDR_MDQS0: U2.113 (MDQS0); also elsewhere on the board
DDR_MDQS1: U2.72 (MDQS1); also elsewhere on the board
DDR_MODT: U2.74 (MODT); also elsewhere on the board
DDR_RASN: U2.81 (MRAS); also elsewhere on the board
DDR_VREF: C8.1, U2.90 (DDR_IO_VREF_1), U2.104 (DDR_IO_VREF_2); also elsewhere on the board
DDR_WEN: U2.102 (MW_E); also elsewhere on the board
GND: C8.2, C9.2, C10.2, C11.2, C12.2, C13.2, C14.1, C15.1, C16.1, C37.1, C38.1, C39.1, C40.1, U2.63 (DDR_IO_VSS_1), U2.115 (DDR_IO_VSS_2); also elsewhere on the board
MADDR0: U2.80 (MA0); also elsewhere on the board
MADDR1: U2.88 (MA1); also elsewhere on the board
MADDR2: U2.87 (MA2); also elsewhere on the board
MADDR3: U2.97 (MA3); also elsewhere on the board
MADDR4: U2.82 (MA4); also elsewhere on the board
MADDR5: U2.93 (MA5); also elsewhere on the board
MADDR6: U2.86 (MA6); also elsewhere on the board
MADDR7: U2.95 (MA7); also elsewhere on the board
MADDR8: U2.84 (MA8); also elsewhere on the board
MADDR9: U2.94 (MA9); also elsewhere on the board
MADDR10: U2.92 (MA10); also elsewhere on the board
MADDR11: U2.85 (MA11); also elsewhere on the board
MADDR12: U2.96 (MA12); also elsewhere on the board
MDATA0: U2.71 (MD0); also elsewhere on the board
MDATA1: U2.107 (MD1); also elsewhere on the board
MDATA2: U2.69 (MD2); also elsewhere on the board
MDATA3: U2.105 (MD3); also elsewhere on the board
MDATA4: U2.106 (MD4); also elsewhere on the board
MDATA5: U2.73 (MD5); also elsewhere on the board
MDATA6: U2.109 (MD6); also elsewhere on the board
MDATA7: U2.70 (MD7); also elsewhere on the board
MDATA8: U2.66 (MD8); also elsewhere on the board
MDATA9: U2.112 (MD9); also elsewhere on the board
MDATA10: U2.68 (MD10); also elsewhere on the board
MDATA11: U2.110 (MD11); also elsewhere on the board
MDATA12: U2.111 (MD12); also elsewhere on the board
MDATA13: U2.67 (MD13); also elsewhere on the board
MDATA14: U2.114 (MD14); also elsewhere on the board
MDATA15: U2.65 (MD15); also elsewhere on the board

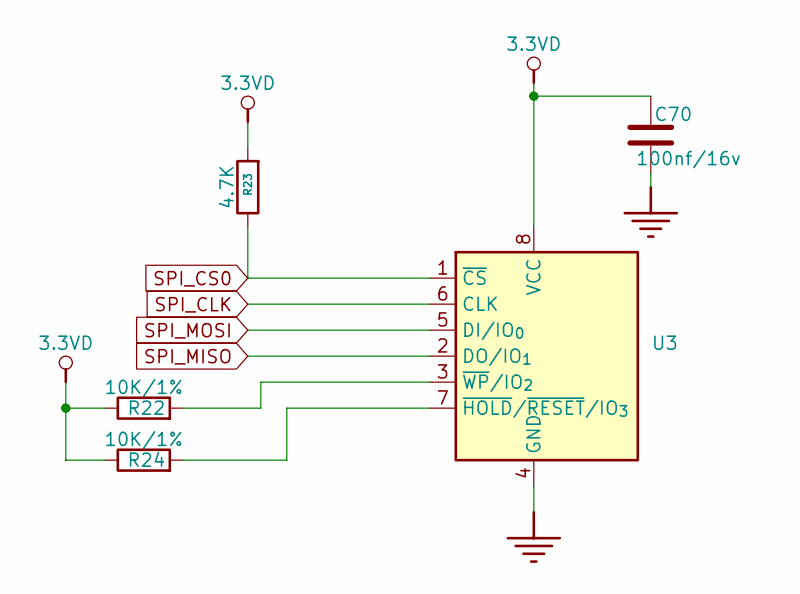
[picture p9: schematic SPI_Flash.kicad_sch]

Parts:
C70: 100nf/16v; C_0402_1005Metric; LCSC C1525
R22, R24: 10K/1%; R_0402_1005Metric; LCSC C25744
R23: 4.7K; R_0402_1005Metric; LCSC C25900
U3: W25Q256JVEIQ; WSON-8_L8.0-W6.10-P1.27-BL-EP; LCSC C97522

Connections:
3.3VD: C70.1, R22.1, R23.2, R24.1, U3.8 (VCC); also elsewhere on the board
GND: C70.2, U3.4 (GND), U3.9, U3.gnd; also elsewhere on the board
unnamed: R24.2, U3.7 (~HOLD/~RESET/IO_{3})
unnamed: R22.2, U3.3 (~WP/IO_{2})
SPI_CLK: U3.6 (CLK); also elsewhere on the board
SPI_CS0: R23.1, U3.1 (~CS); also elsewhere on the board
SPI_MISO: U3.2 (DO/IO_{1}); also elsewhere on the board
SPI_MOSI: U3.5 (DI/IO_{0}); also elsewhere on the board

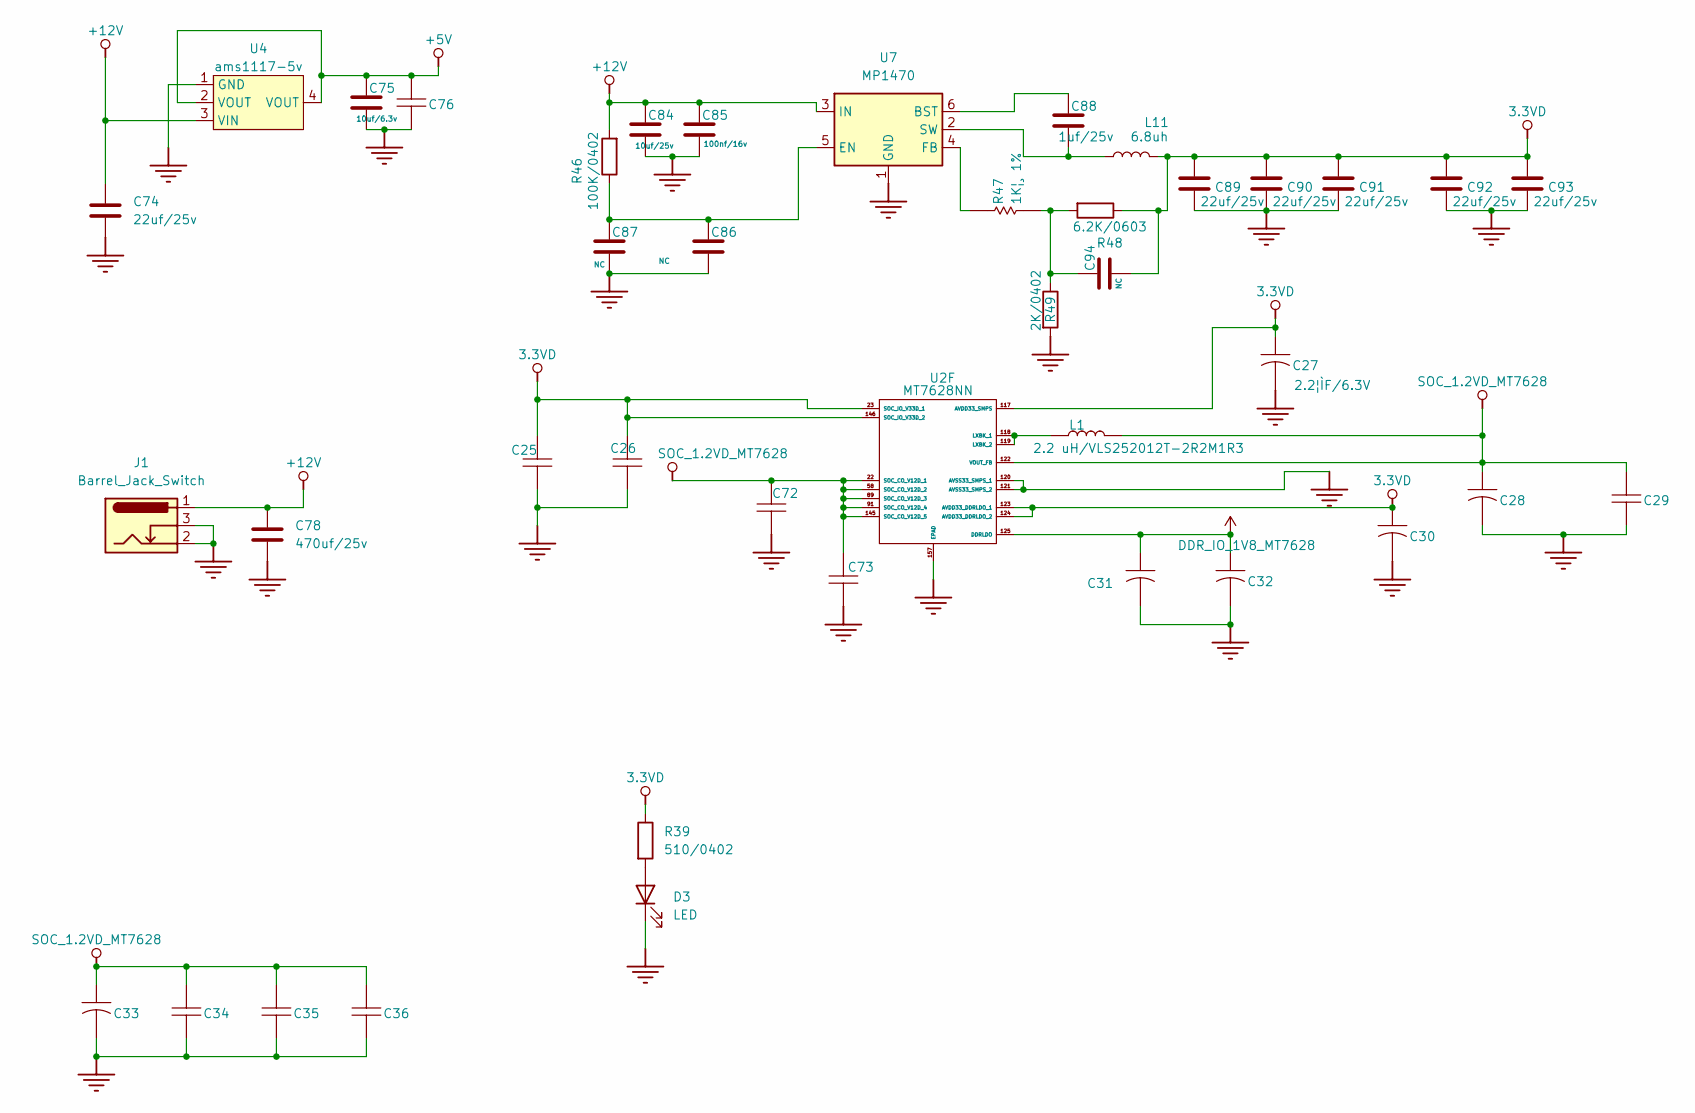
[picture p10: schematic power.kicad_sch]

Parts:
C25, C26, C29, C34, C35, C36, C76, C85: 100nf/16v; C_0402_1005Metric; LCSC C1525
C27: 2.2uF/6.3V; C_0603_1608Metric; LCSC C71000
C28, C75: 10uf/6.3v; C_0603_1608Metric; LCSC C1691
C30: 1uf/6.3v; C_0402_1005Metric; LCSC C15684
C31: 2.2uf/6.3v; C_0603_1608Metric; LCSC C71000
C32, C33: 4.7uf/6.3v; C_0603_1608Metric; LCSC C8032
C72, C73: 15pf/50v; C_0402_1005Metric; LCSC C1548
C74, C89, C90, C91, C92, C93: 22uf/25v; C_0603_1608Metric; LCSC C84419
C78: 470uf/25v; CAP-TH_BD8.0-P3.50-D0.6-FD; LCSC C5154
C84: 10uf/25v; C_0603_1608Metric; LCSC C13585
C86, C87, C94: NC; C_0402_1005Metric
C88: 1uf/25v; C_0402_1005Metric; LCSC C52923
D3: LED; D_0603_1608Metric; LCSC C2286
J1: Barrel_Jack_Switch; DC-IN-TH_DC-005C-20A; LCSC C84007
L1: 2.2 uH/VLS252012ET-2R2M; IND-SMD_L2.5-W2.0_VLS2520X; LCSC C107346
L11: 6.8uh; IND-SMD_L4.5-W4.0_GCD43-XX; LCSC C10131
R39: 510/0402; R_0402_1005Metric; LCSC C25123
R46: 100K/0402; R_0402_1005Metric; LCSC C25741
R47: 1k/1%; R_0402_1005Metric; LCSC C11702
R48: 6.2K/0603; C_0603_1608Metric; LCSC C4260
R49: 2K/0402; C_0402_1005Metric; LCSC C4109
U2: MT7628NN; MT7628_footprint; LCSC C2762437
U4: ams1117-5v; SOT-223_L6.5-W3.5-P2.30-LS7.0-BR; LCSC C6187
U7: MP1470; TSOT-23-6; LCSC C558426

Connections:
3.3VD: C25.2, C26.2, C27.1, C30.1, C89.1, C90.1, C91.1, C92.1, C93.1, C94.2, L11.2, R39.1, R48.1, U2.23 (SOC_IO_V33D_1), U2.117 (AVDD33_SMPS), U2.123 (AVDD33_DDRLDO_1), U2.124 (AVDD33_DDRLDO_2), U2.146 (SOC_IO_V33D_2); also elsewhere on the board
+5V: C75.1, C76.2, U4.2 (VOUT), U4.4 (VOUT); also elsewhere on the board
+12V: C74.1, C78.1, C84.1, C85.1, J1.1, R46.2, U4.3 (VIN), U7.3 (IN)
DDR_IO_1V8_MT7628: C31.1, C32.1, U2.125 (DDRLDO); also elsewhere on the board
GND: C25.1, C26.1, C27.2, C28.2, C29.1, C30.2, C31.2, C32.2, C33.2, C34.1, C35.1, C36.1, C72.1, C73.2, C74.2, C75.2, C76.1, C78.2, C84.2, C85.2, C86.2, C87.2, C89.2, C90.2, C91.2, C92.2, C93.2, D3.1 (K), J1.2, J1.3, R49.2, U2.120 (AVSS33_SMPS_1), U2.121 (AVSS33_SMPS_2), U2.157 (EPAD), U4.1 (GND), U7.1 (GND); also elsewhere on the board
unnamed: C94.1, R47.1, R48.2, R49.1
unnamed: D3.2 (A), R39.2
unnamed: L1.1, U2.118 (LXBK_1), U2.119 (LXBK_2)
unnamed: C88.1, U7.6 (BST)
unnamed: C86.1, C87.1, R46.1, U7.5 (EN)
unnamed: R47.2, U7.4 (FB)
unnamed: C88.2, L11.1, U7.2 (SW)
SOC_1.2VD_MT7628: C28.1, C29.2, C33.1, C34.2, C35.2, C36.2, C72.2, C73.1, L1.2, U2.22 (SOC_CO_V12D_1), U2.58 (SOC_CO_V12D_2), U2.89 (SOC_CO_V12D_3), U2.91 (SOC_CO_V12D_4), U2.122 (VOUT_FB), U2.145 (SOC_CO_V12D_5)

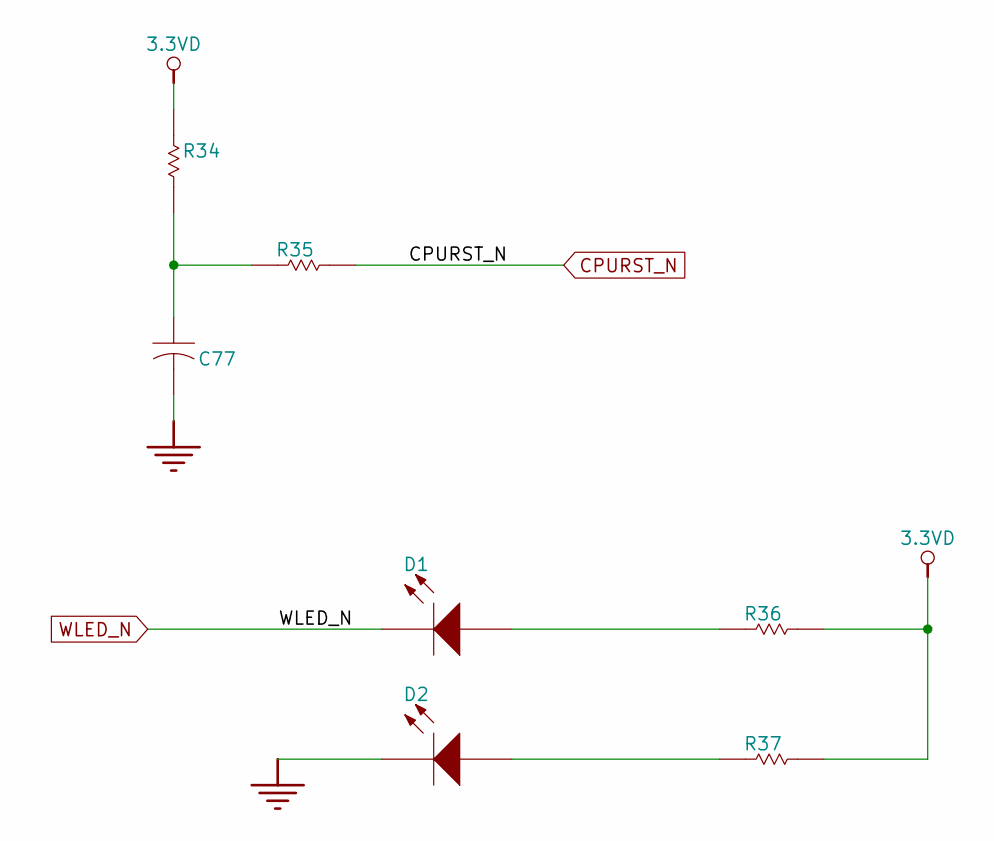
[picture p11: schematic reset.kicad_sch]

Parts:
C77: 4.7uf/6.3v; C_0603_1608Metric; LCSC C8032
D1, D2: LED0; LED_0603_1608Metric; LCSC C2286
R34: 20K/1%; R_0402_1005Metric; LCSC C25545
R35: 22; R_0402_1005Metric; LCSC C25092
R36, R37: 330; R_0402_1005Metric; LCSC C25104

Connections:
3.3VD: R34.2, R36.1, R37.1; also elsewhere on the board
CPURST_N: R35.1; also elsewhere on the board
GND: C77.2, D2.2 (K); also elsewhere on the board
unnamed: C77.1, R34.1, R35.2
unnamed: D1.1 (A), R36.2
unnamed: D2.1 (A), R37.2
WLED_N: D1.2 (K); also elsewhere on the board

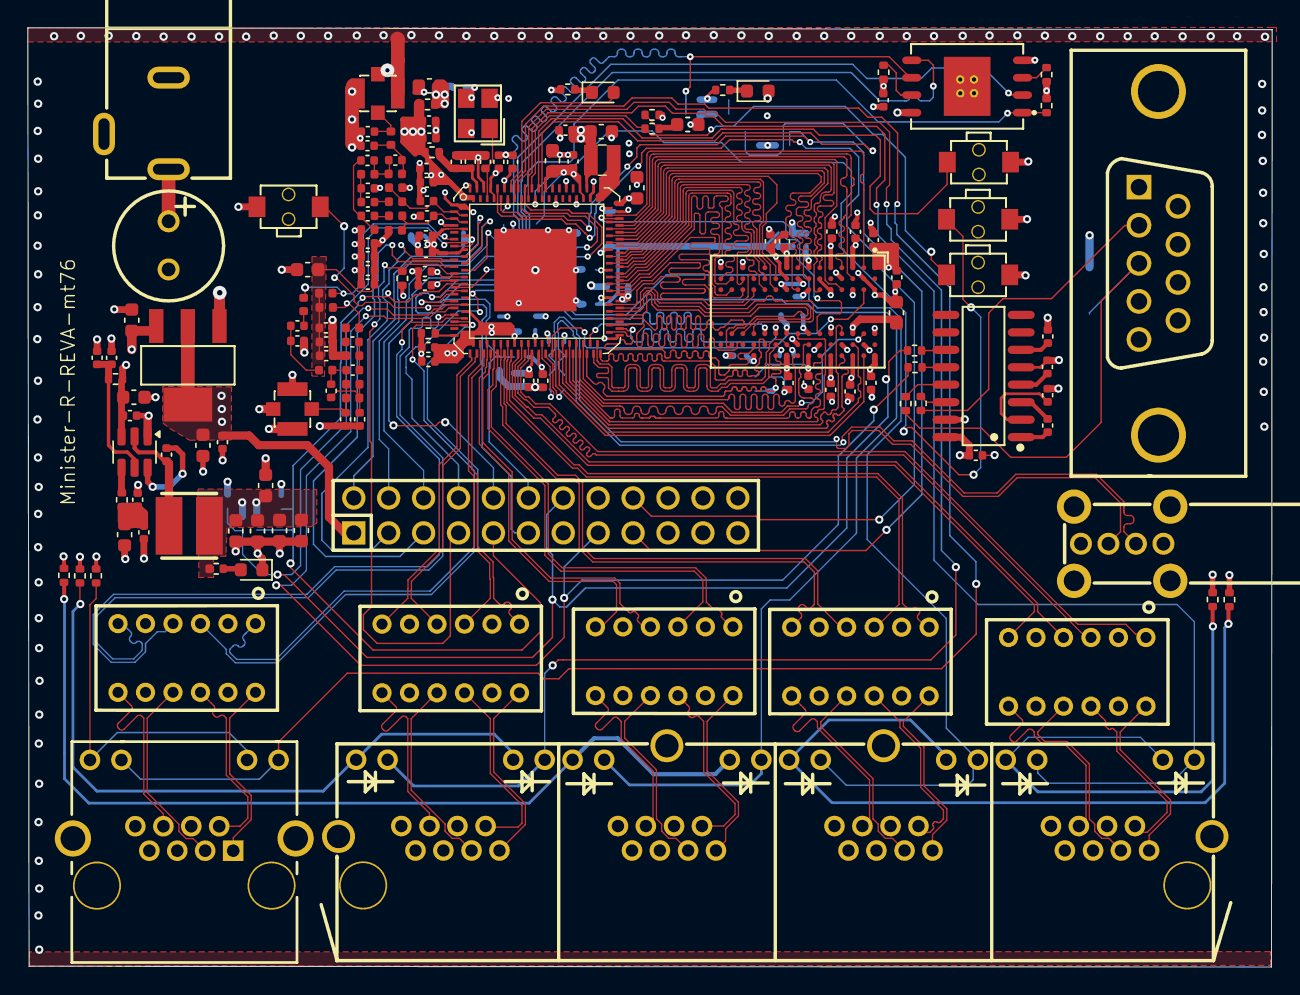
[picture p12: board mt7628v1.kicad_pcb from above]

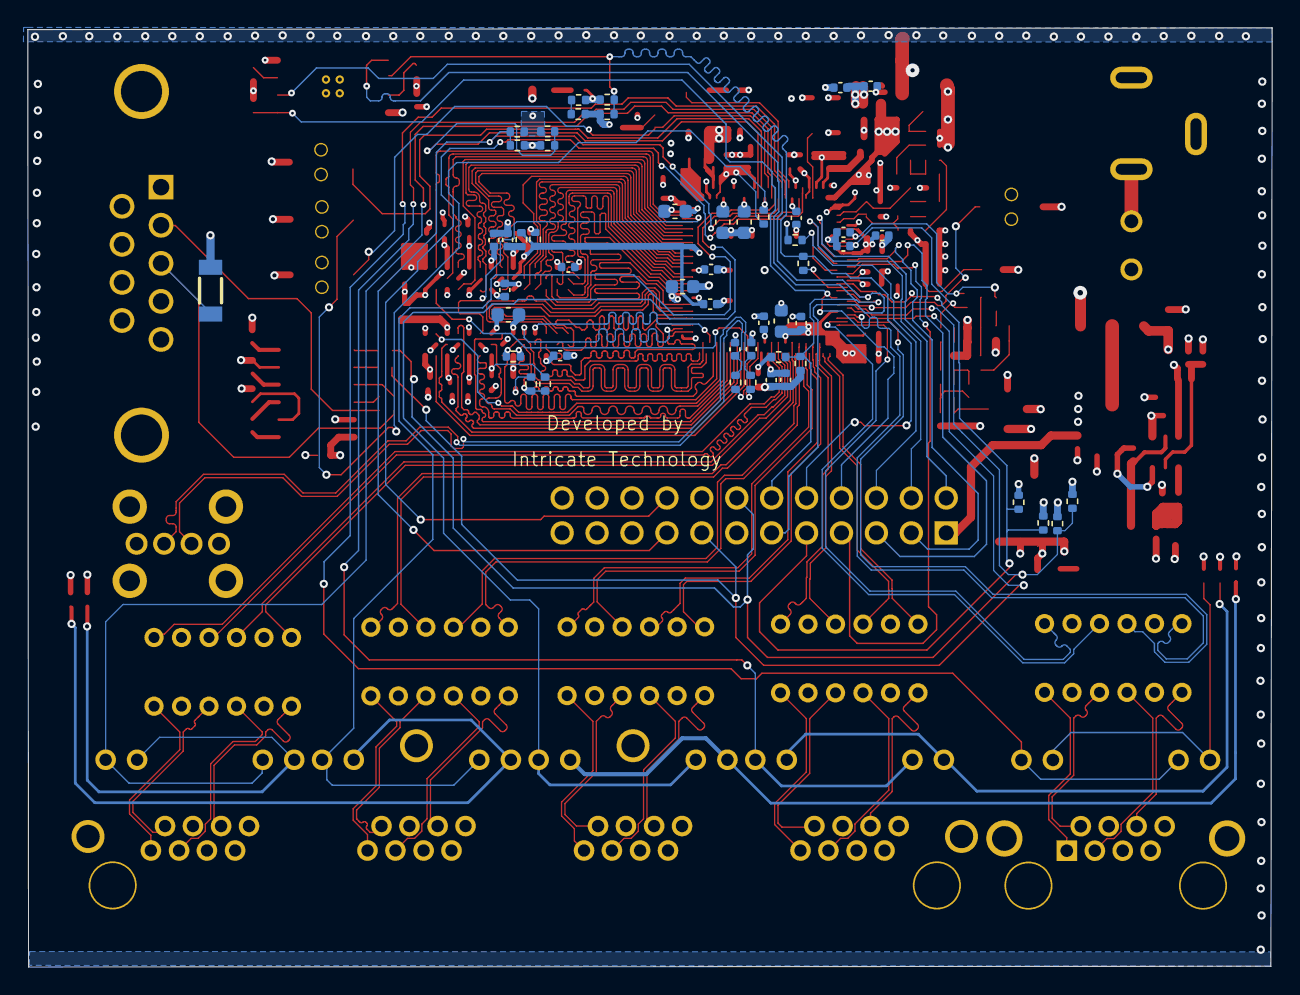
[picture p13: board mt7628v1.kicad_pcb from below]

Board: 4 copper layers, 90.5 x 68.3 mm, 201 parts (50 on the bottom side), 176 nets.
