findasifrahman/mt76--/(commit log)

2025-03-12 updated aux
    [Pheripheral.kicad_sch, RF_Front_End.kicad_sch, ddr_if.kicad_sch, power.kicad_sch]
2025-05-23 final_all_router by asif
    [Pheripheral.kicad_sch, RF_Front_End.kicad_sch, SPI_Flash.kicad_sch, bom.csv, config.kicad_sch, ddr_cfg.kicad_sch, ddr_if.kicad_sch, designators.csv]
